MidwestMotorBoy/Double-DRV-Motor-Controller/HARDWARE/DRV8350S_Double/DRV8350S_Double_2.0_Front.jpg

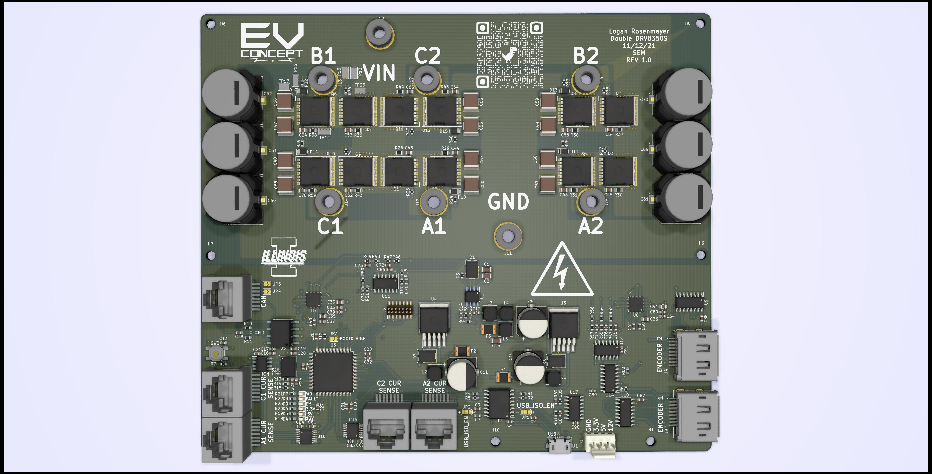
HARDWARE/DRV8350S_Double/DRV8350S_Double_2.0_Front.jpg
