MidwestMotorBoy/Double-DRV-Motor-Controller/HARDWARE/MA732_encoder/MA732_encoder/MA710_encoder_back.jpg

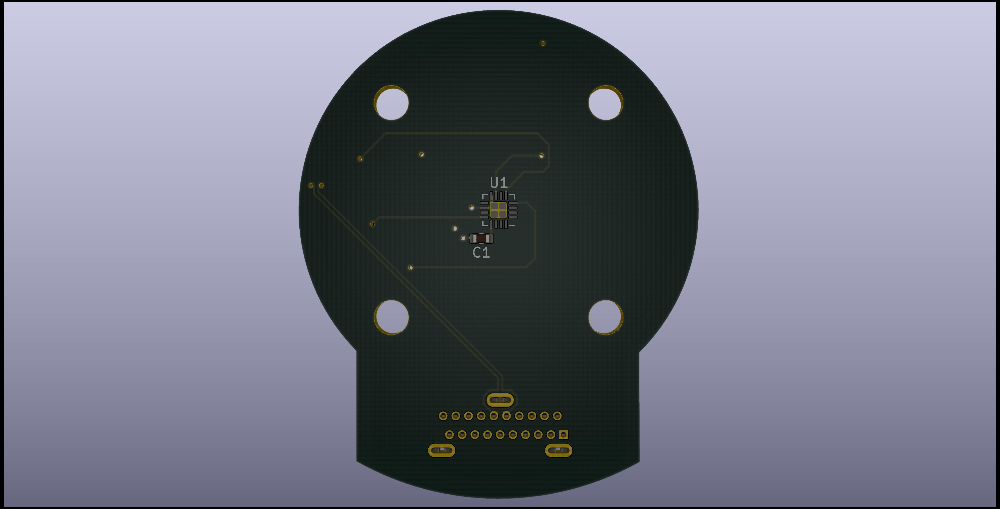
HARDWARE/MA732_encoder/MA732_encoder/MA710_encoder_back.jpg
