MidwestMotorBoy/Double-DRV-Motor-Controller/HARDWARE/DRV8350S_Double/DRV8350S_Double.jpg

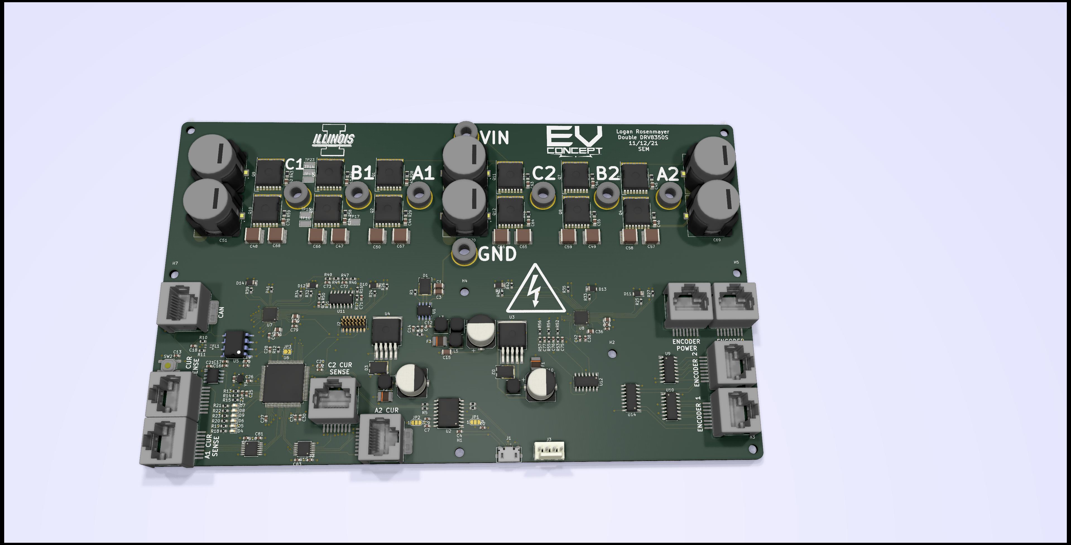
HARDWARE/DRV8350S_Double/DRV8350S_Double.jpg
