MidwestMotorBoy/Double-DRV-Motor-Controller/HARDWARE/MA732_encoder/MA710_encoder.jpg

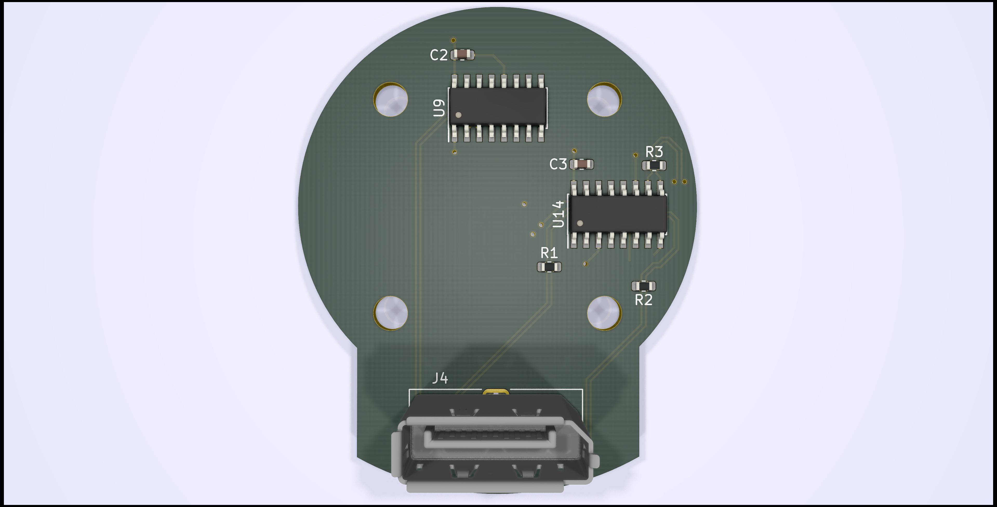
HARDWARE/MA732_encoder/MA710_encoder.jpg
