MidwestMotorBoy/Double-DRV-Motor-Controller/HARDWARE/DRV8350S_Double/SCHEM_0.5.pdf

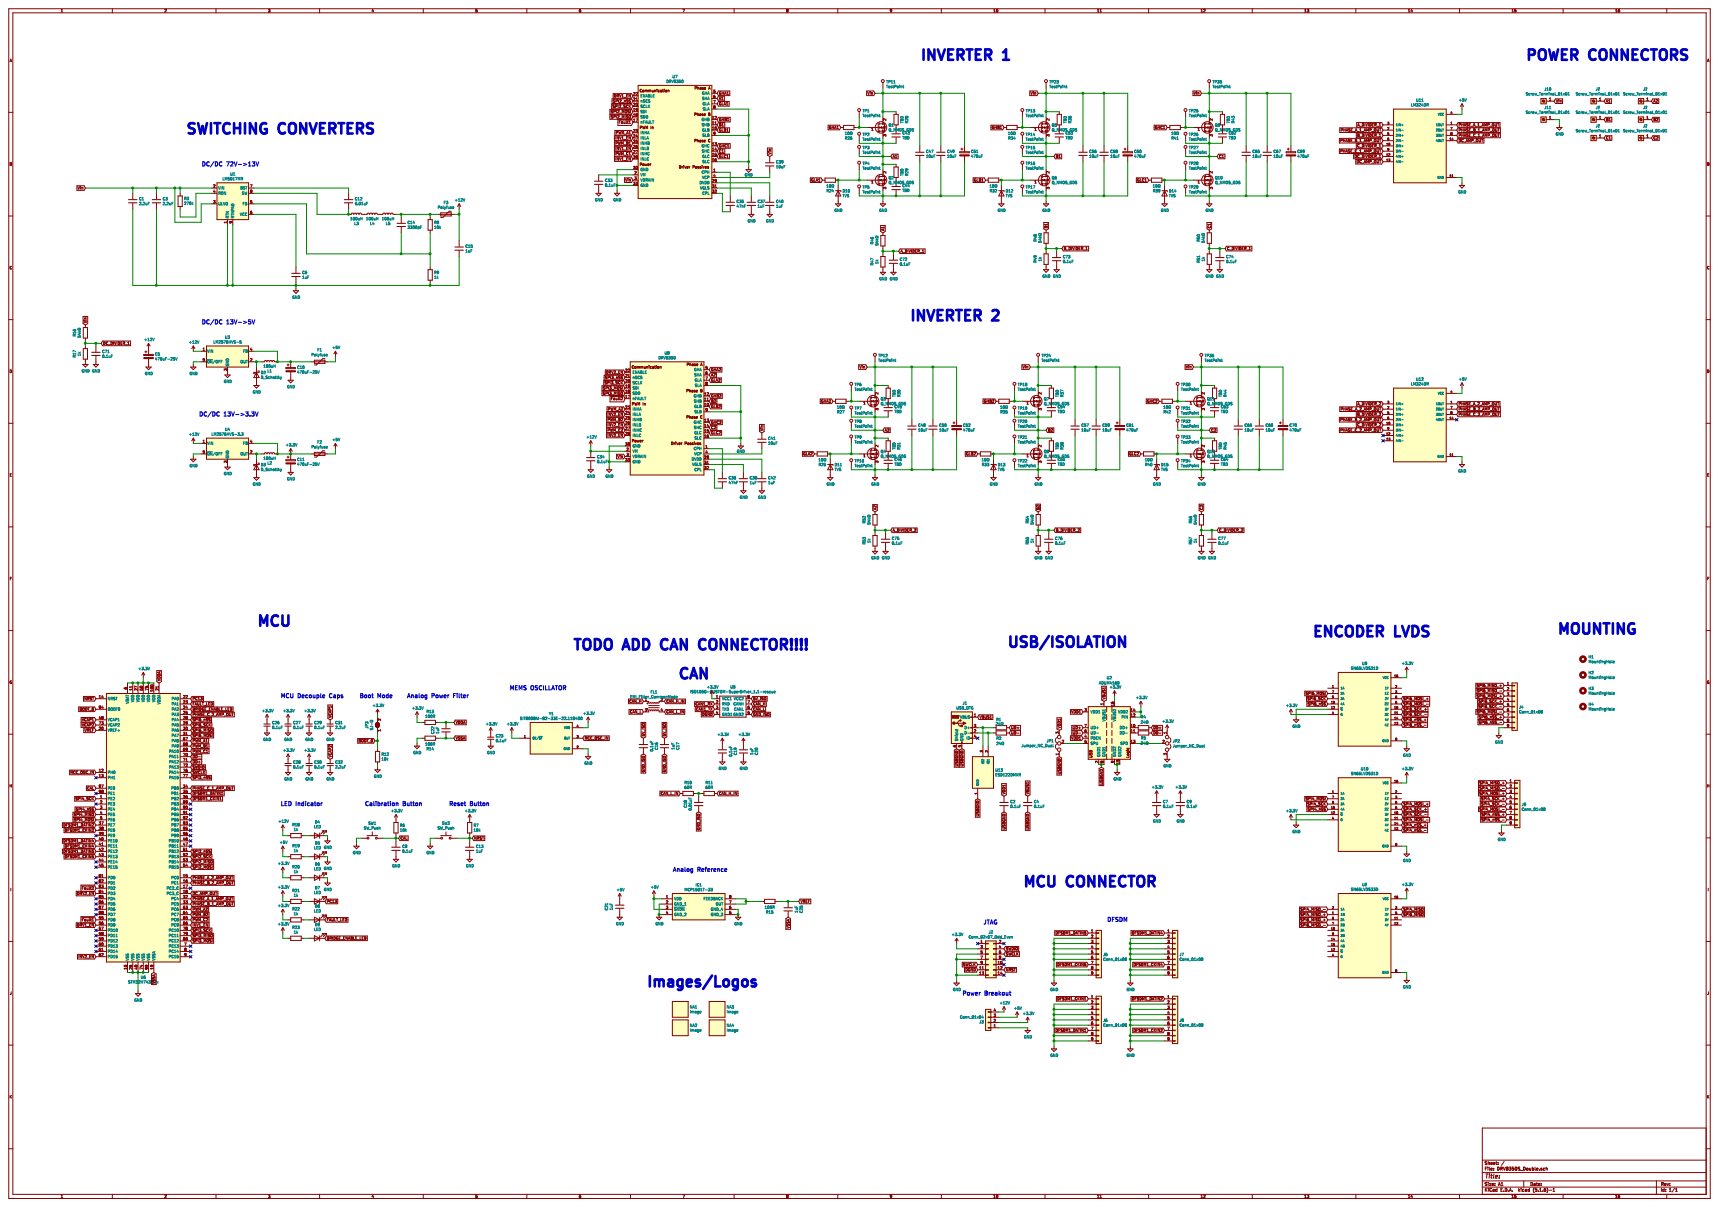
[picture p8: page 1]
