MidwestMotorBoy/Double-DRV-Motor-Controller/HARDWARE/MA732_encoder/MA710_encoder.kicad_pcb

## KiCad design HARDWARE/MA732_encoder/MA710_encoder.kicad_pcb (2022-06-25)

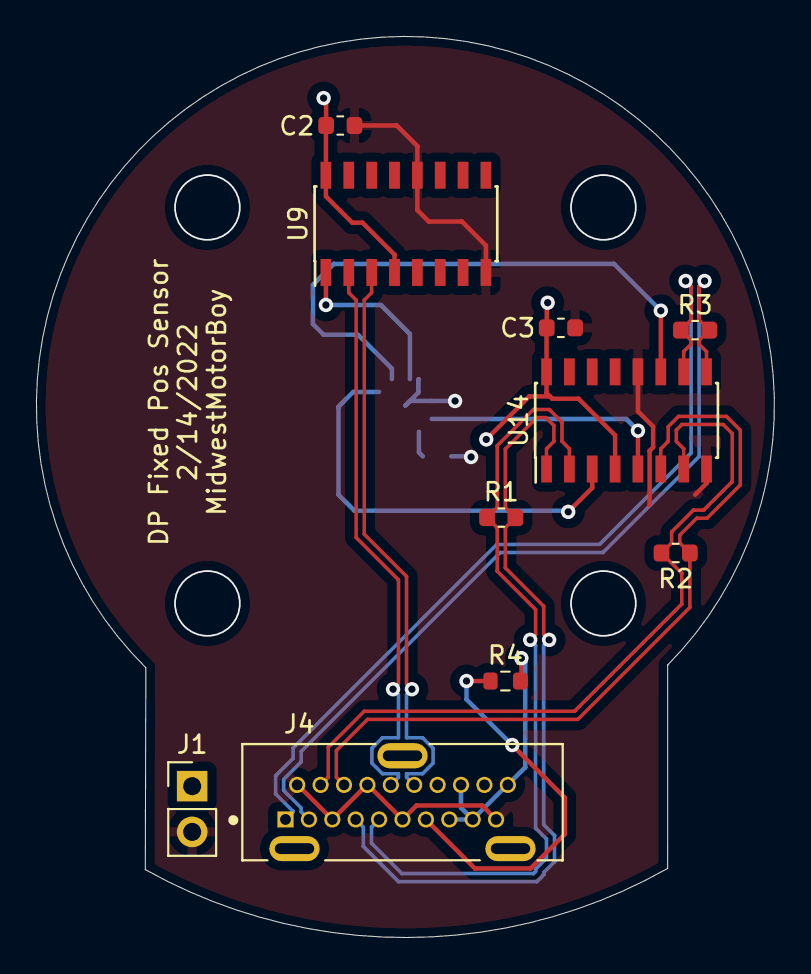
[picture p9: board HARDWARE/MA732_encoder/MA710_encoder.kicad_pcb from above]

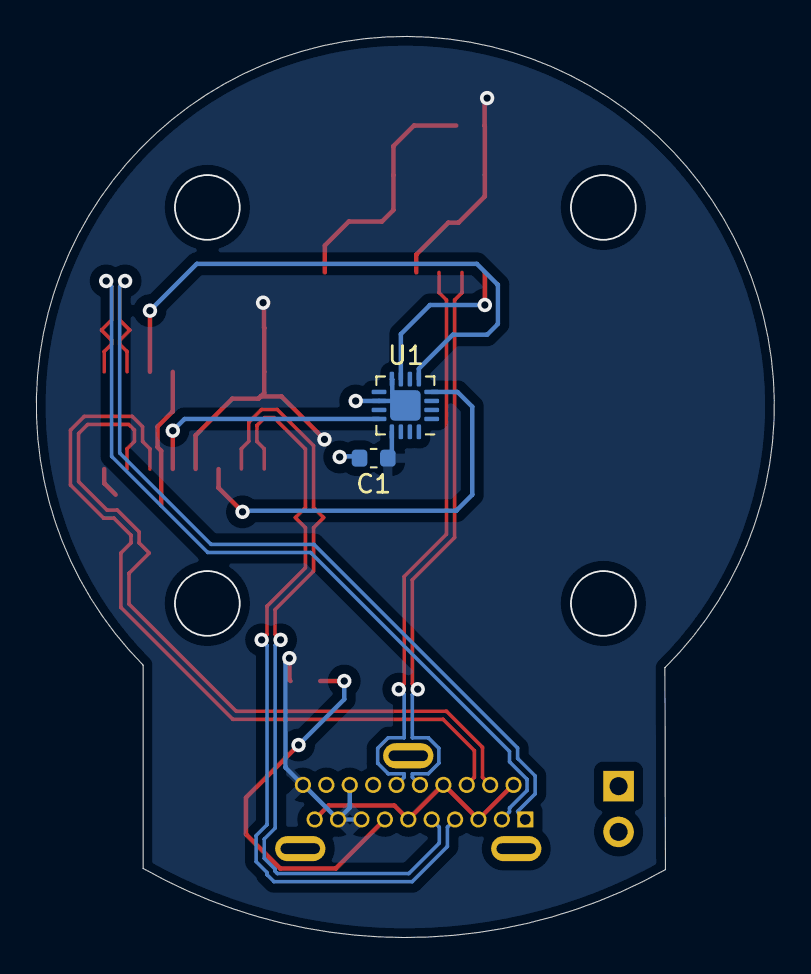
[picture p10: board HARDWARE/MA732_encoder/MA710_encoder.kicad_pcb from below]

Board: 2 copper layers, 41.0 x 50.1 mm, 12 parts (2 on the bottom side), 15 nets.

Parts:
C1, C2, C3: 1uF; C_0603_1608Metric
J1: Conn_01x02_Male; PinHeader_1x02_P2.54mm_Vertical
J4: 47272-0001; TE_2041441-1
R1, R2, R3: 100Ω; R_0603_1608Metric
R4: 0Ω; R_0603_1608Metric
U1: MA730; QFN-16-1EP_3x3mm_P0.5mm_EP1.7x1.7mm
U9: SN65LVDS31D; SOIC-16_3.9x9.9mm_P1.27mm
U14: SN65LVDS33D; SOIC-16_3.9x9.9mm_P1.27mm

Connections:
+3V3: C1.1, C2.1, C3.1, J4.15, J4.16, J4.17, J4.20, R4.2, U1.13 (VDD), U9.4 (G), U9.16 (VCC), U14.4 (G), U14.16 (VCC)
GND: C1.2, C2.2, C3.2, J1.2, J4.2, J4.5, J4.8, J4.11, J4.19, U1.8 (GND), U1.10 (TEST), U1.17 (PAD), U9.8 (GND), U9.12 (~G), U14.8 (GND), U14.12 (~G)
SPI6_MISO: U1.7 (MISO), U9.1 (1A)
SPI6_MISO_+: J4.12, U9.3 (1Z)
SPI6_MISO_-: J4.10, U9.2 (1Y)
SPI6_MOSI: U1.4 (MOSI), U14.3 (1Y)
SPI6_MOSI_+: J4.9, R1.1, U14.2 (1A)
SPI6_MOSI_-: J4.7, R1.2, U14.1 (1B)
SPI6_SCK: U1.12 (SCLK), U14.5 (2Y)
SPI6_SCK_+: J4.6, R2.1, U14.6 (2A)
SPI6_SCK_-: J4.4, R2.2, U14.7 (2B)
SPI6_nSS: U1.5 (~CS), U14.11 (3Y)
SPI6_nSS_+: J4.3, R3.1, U14.9 (3B)
SPI6_nSS_-: J4.1, R3.2, U14.10 (3A)
TEMP_1: J1.1, J4.13, R4.1
