MidwestMotorBoy/Double-DRV-Motor-Controller/HARDWARE/CURRENT_SENSE/Current_Sense.kicad_pcb

## KiCad design HARDWARE/CURRENT_SENSE/Current_Sense.kicad_pcb (2022-06-25)

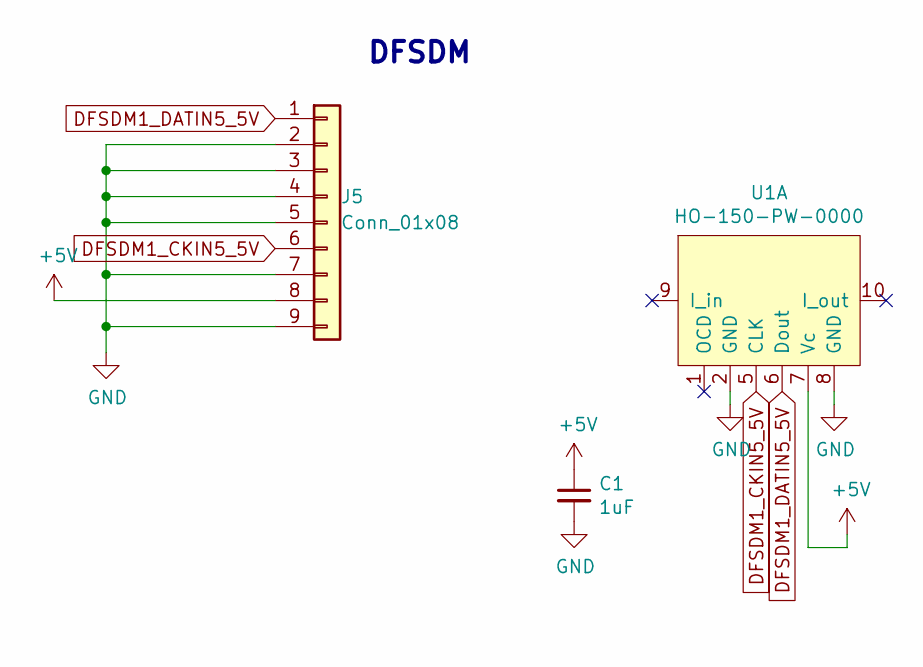
[picture p11: schematic Current_Sense.sch]

Parts:
C1: 1uF; C_0603_1608Metric
J5: Conn_01x08; RCH-RC02015
U1: HO-150-PW-0000

Connections:
+5V: C1.1, J5.8, U1.7 (Vc)
DFSDM1_CKIN5_5V: J5.6, U1.5 (CLK)
DFSDM1_DATIN5_5V: J5.1, U1.6 (Dout)
GND: C1.2, J5.2, J5.3, J5.4, J5.5, J5.7, J5.9, U1.2 (GND), U1.8 (GND)

Notes on the sheet:
DFSDM

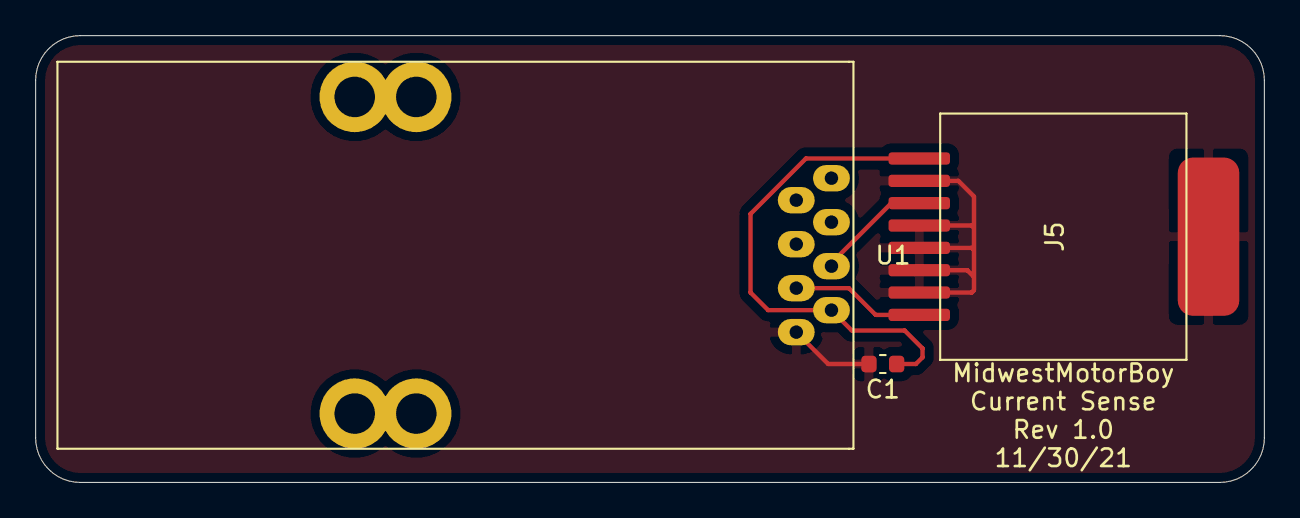
[picture p12: board Current_Sense.kicad_pcb from above]

Board: 2 copper layers, 69.8 x 25.4 mm, 3 parts (0 on the bottom side), 4 nets.
