MidwestMotorBoy/Double-DRV-Motor-Controller/HARDWARE/DRV8350S_Double/DRV8350S_Double.kicad_pcb

## KiCad design HARDWARE/DRV8350S_Double/DRV8350S_Double.kicad_pcb (2022-06-25)

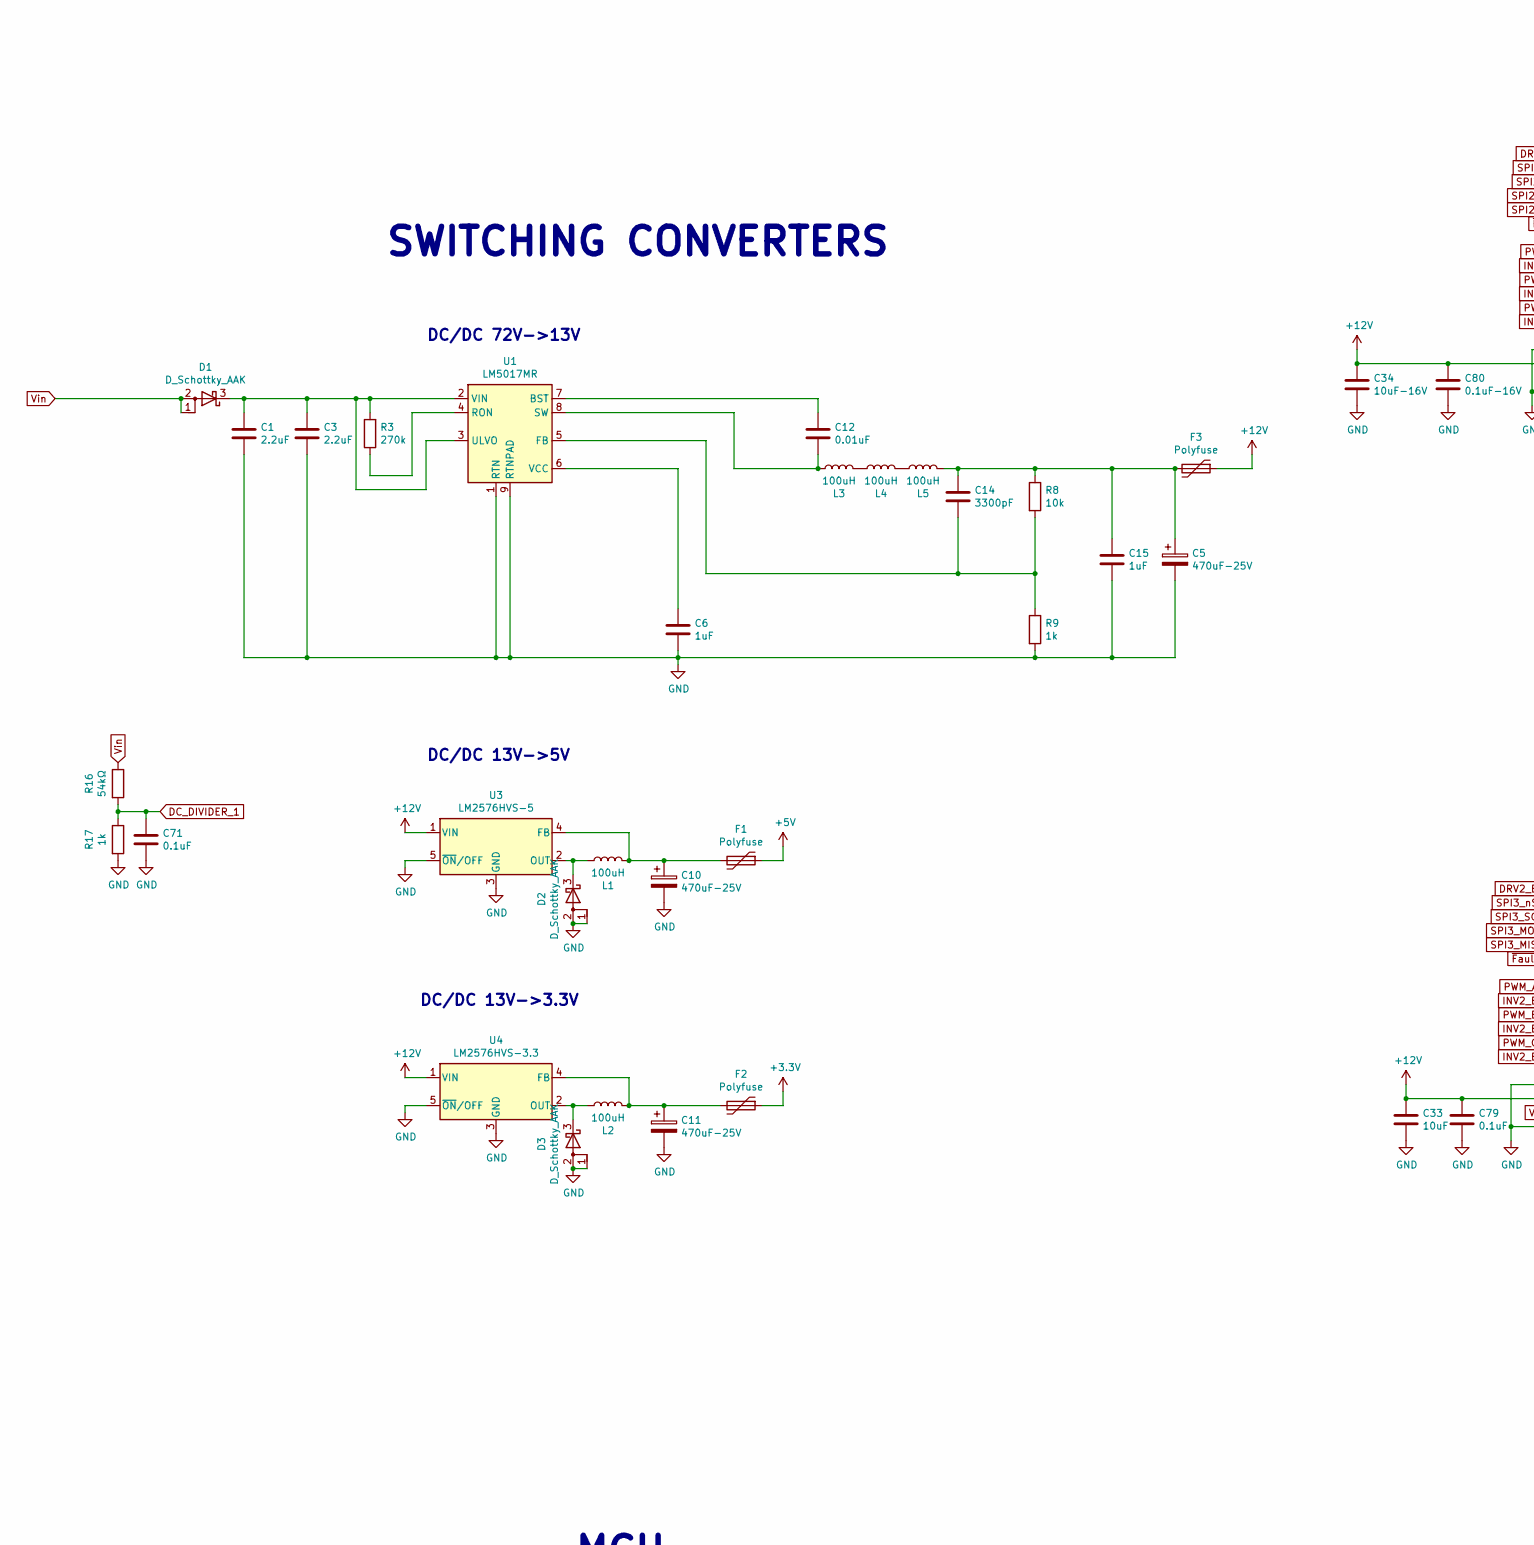
[picture p13: schematic DRV8350S_Double.kicad_sch, part in row 1, column 1]

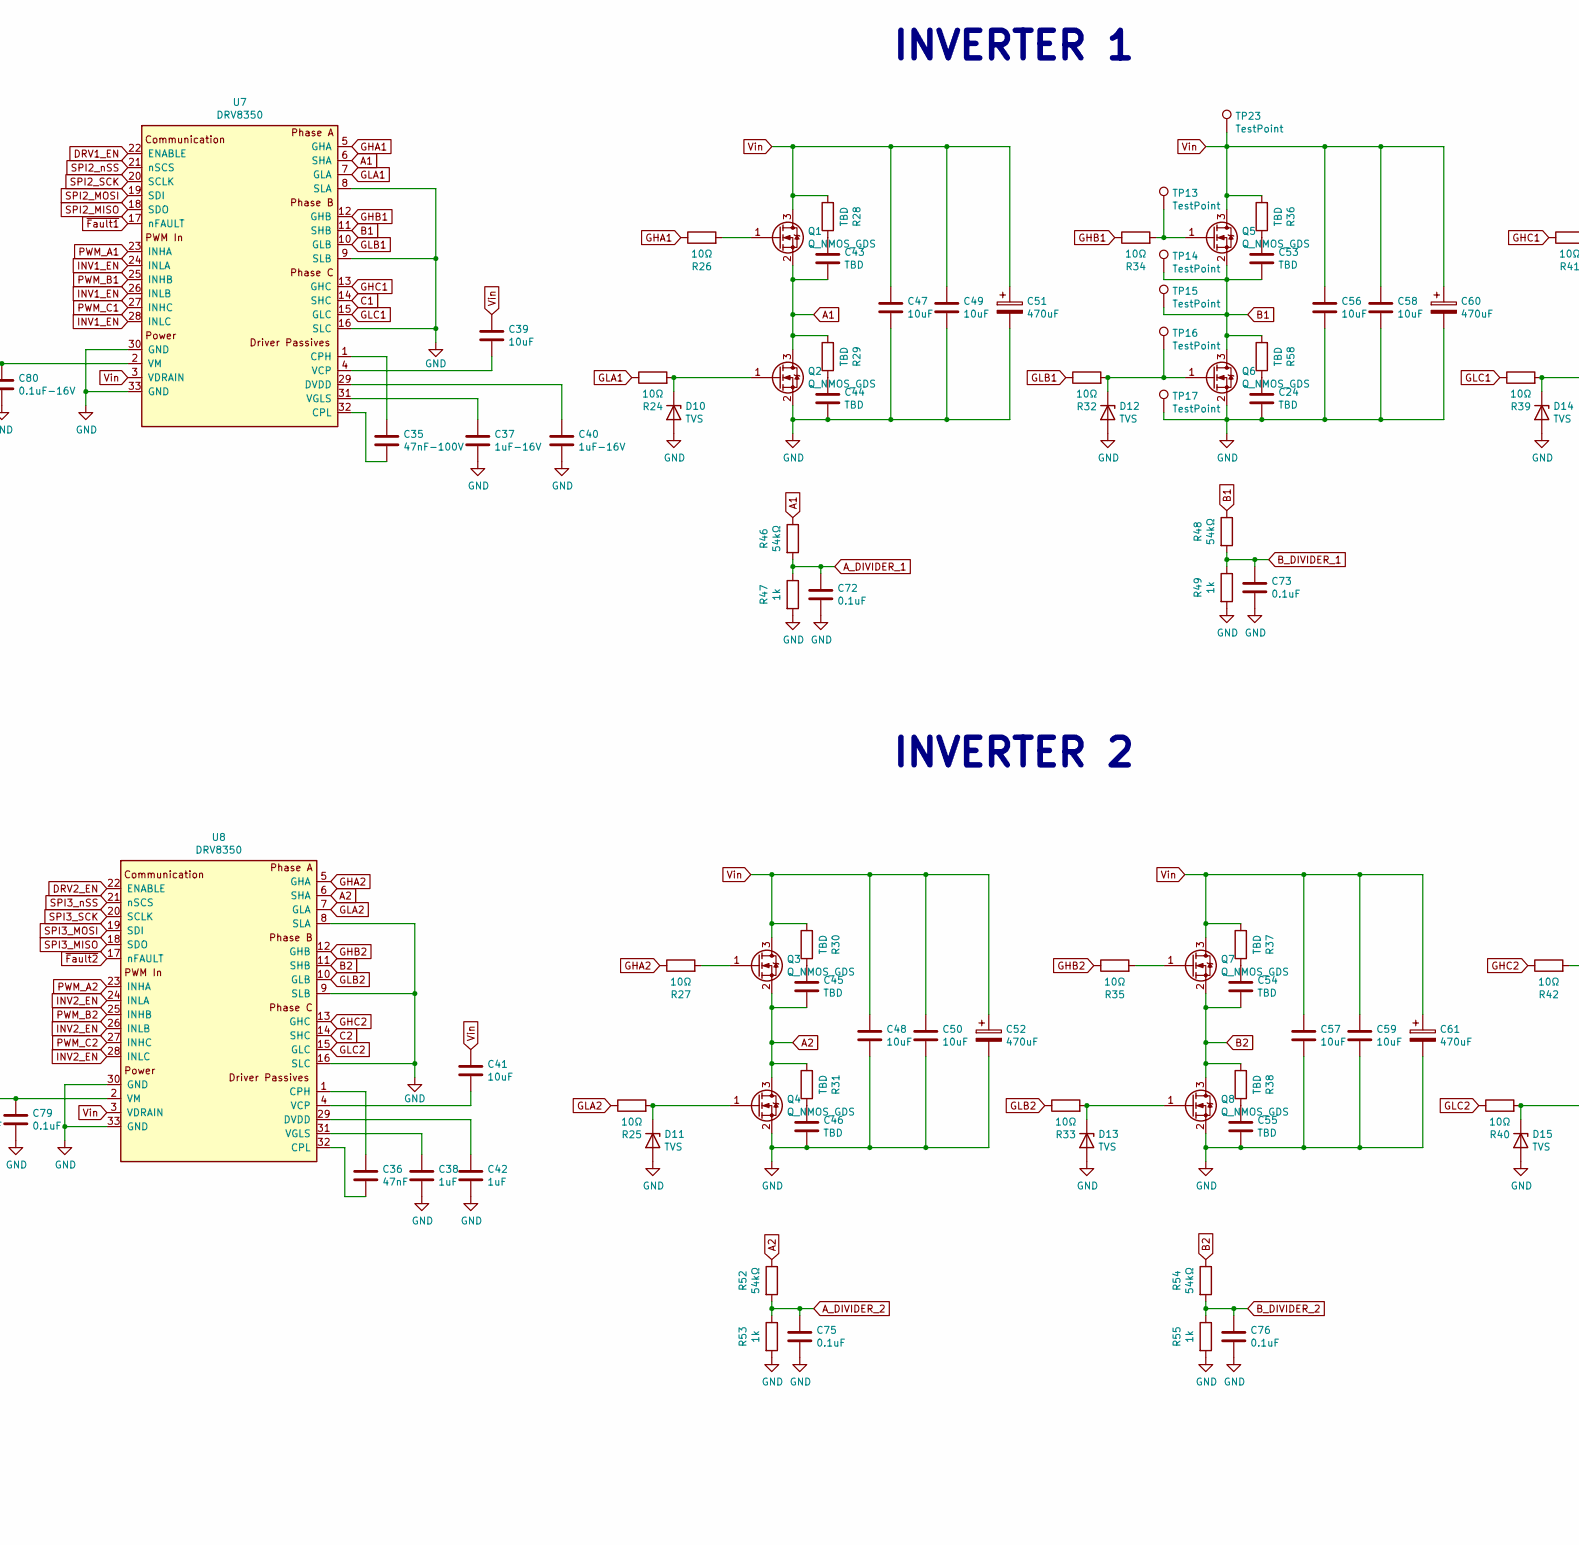
[picture p14: schematic DRV8350S_Double.kicad_sch, part in row 1, column 2]

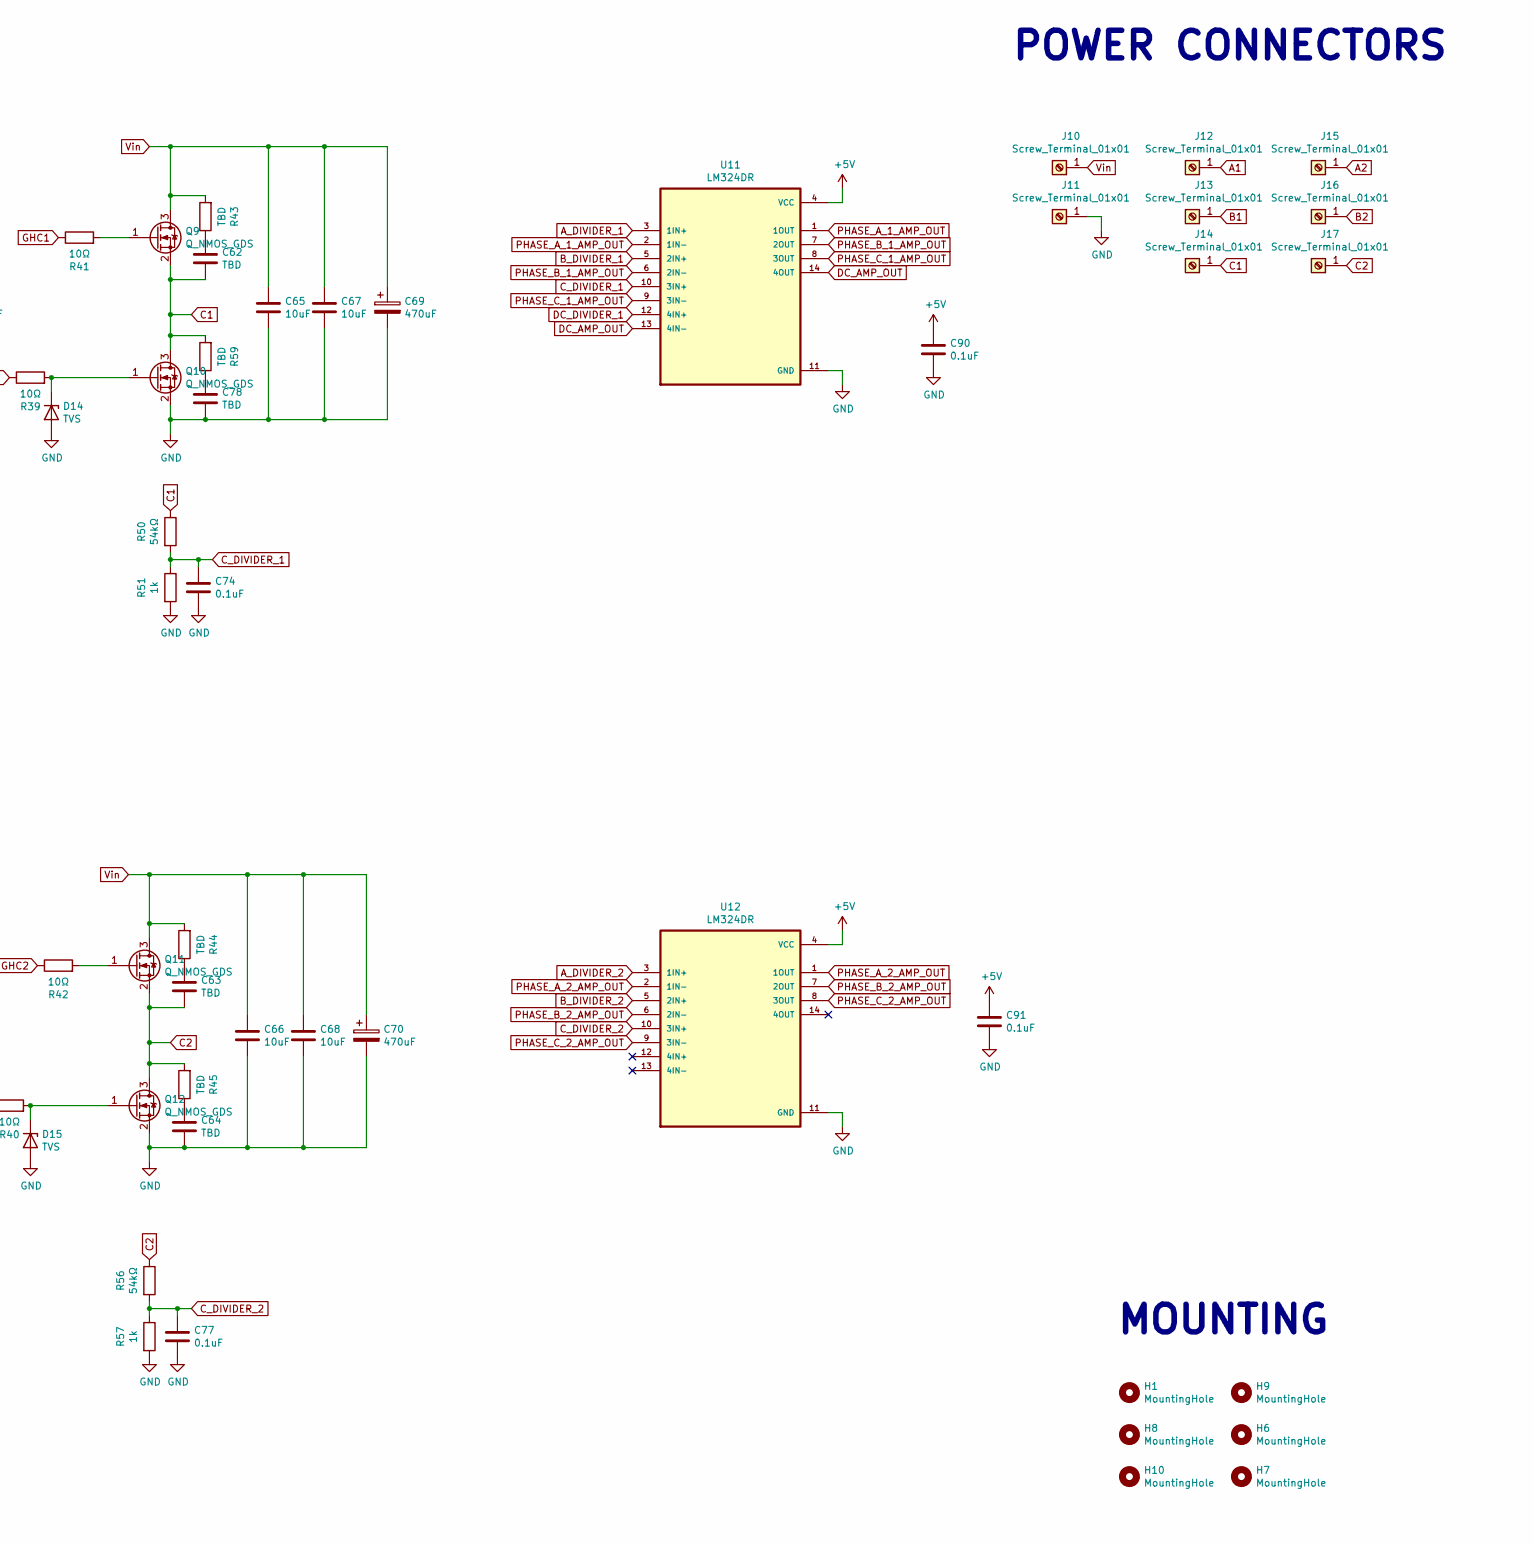
[picture p15: schematic DRV8350S_Double.kicad_sch, part in row 1, column 3]

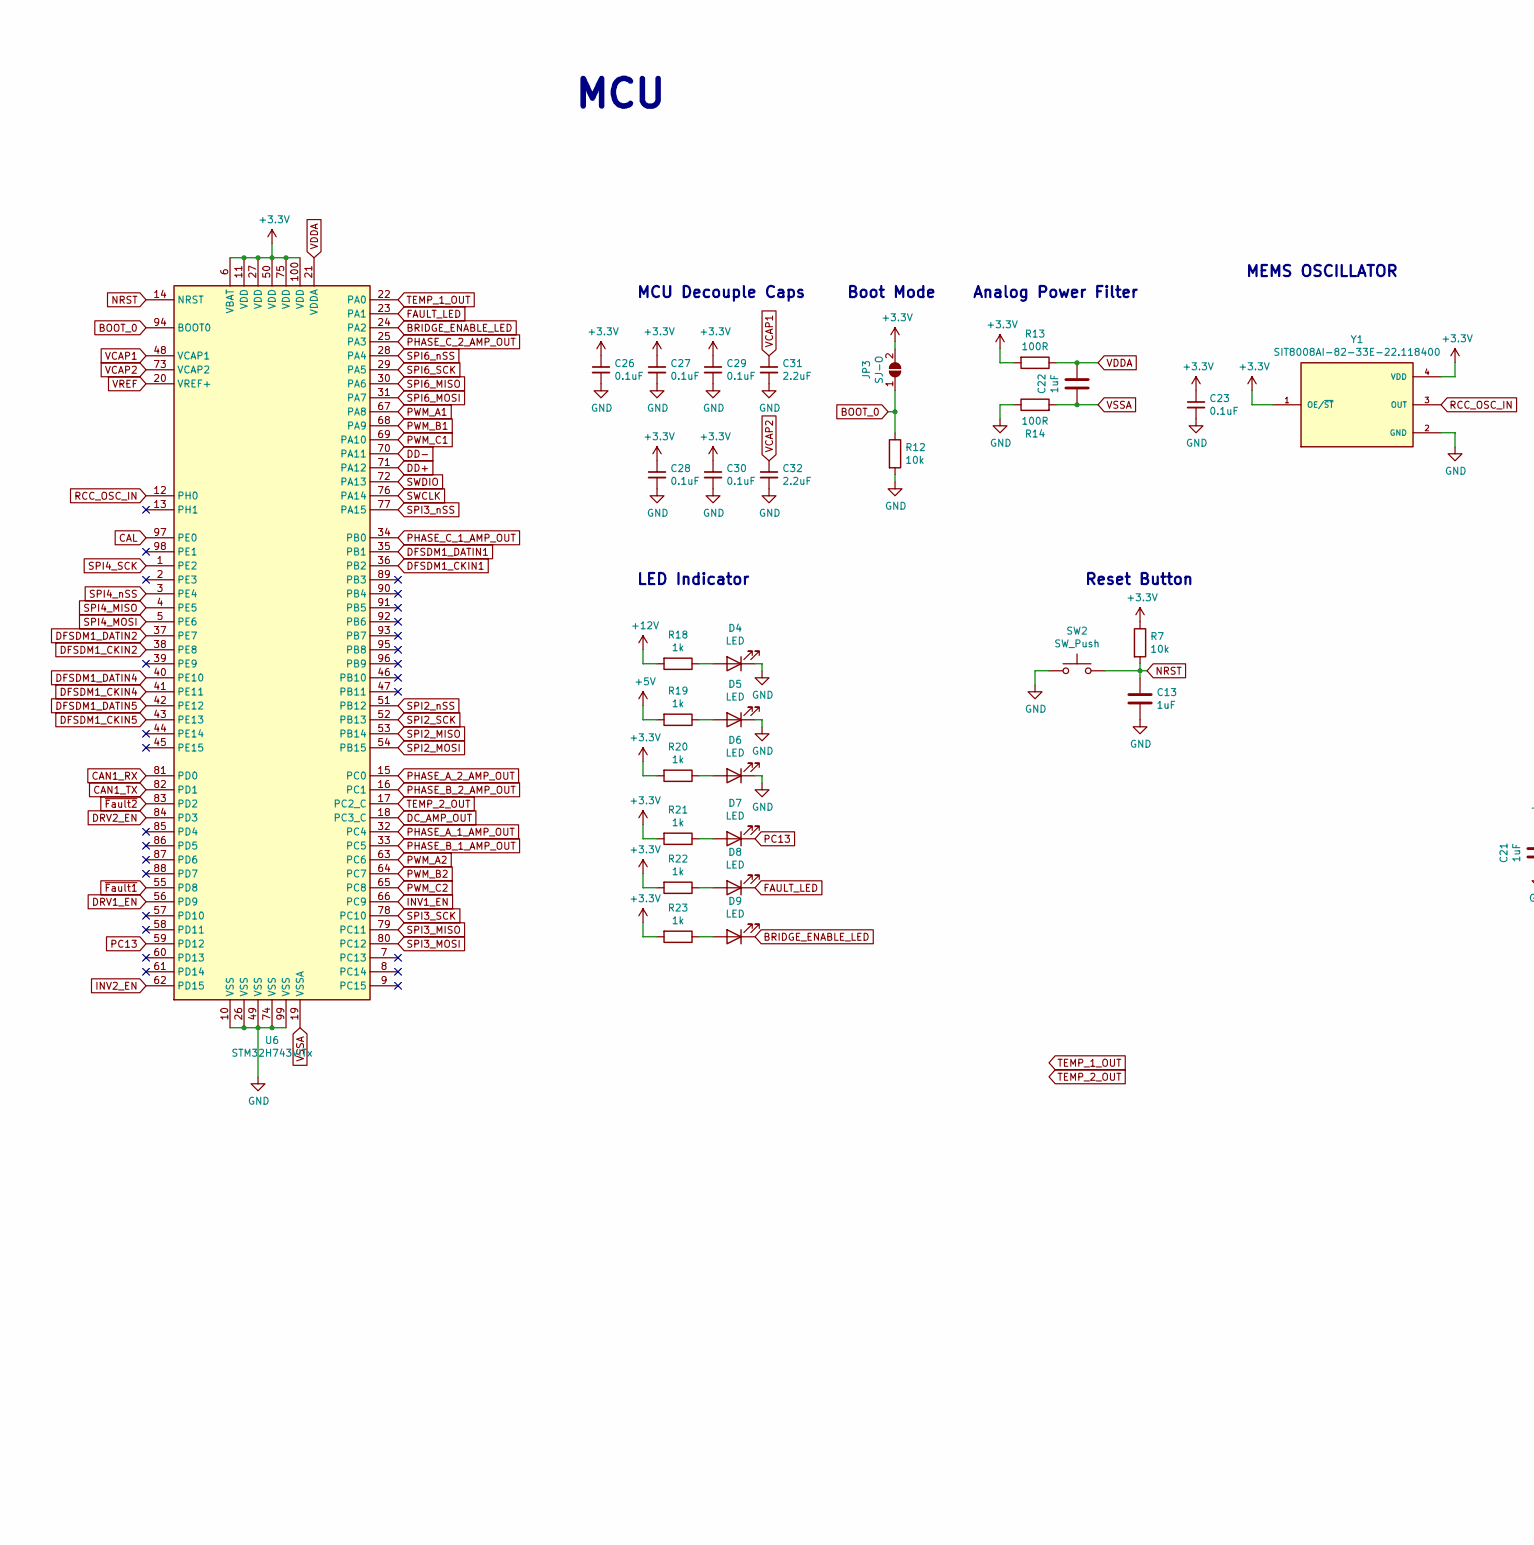
[picture p16: schematic DRV8350S_Double.kicad_sch, part in row 2, column 1]

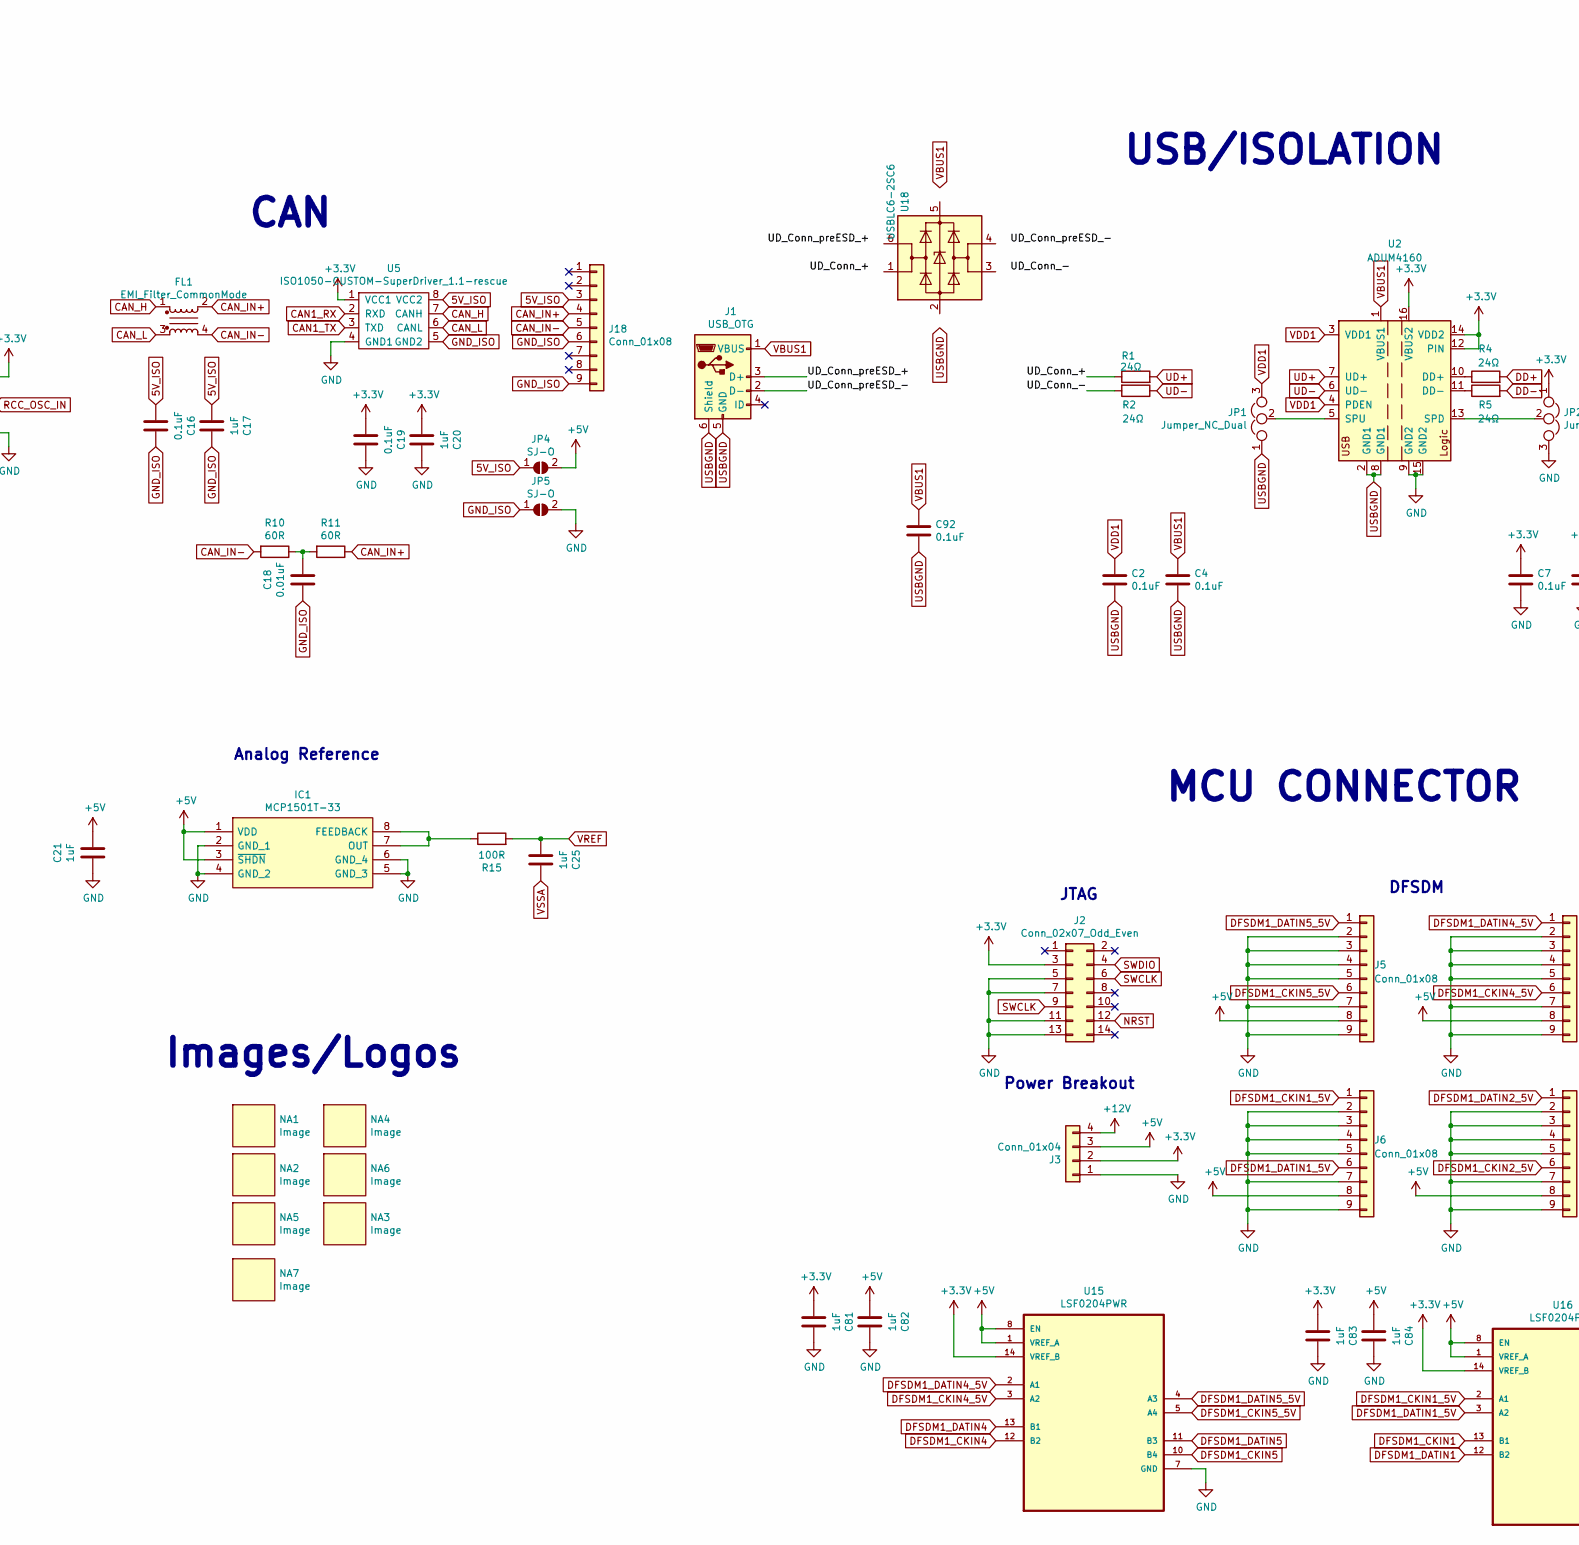
[picture p17: schematic DRV8350S_Double.kicad_sch, part in row 2, column 2]

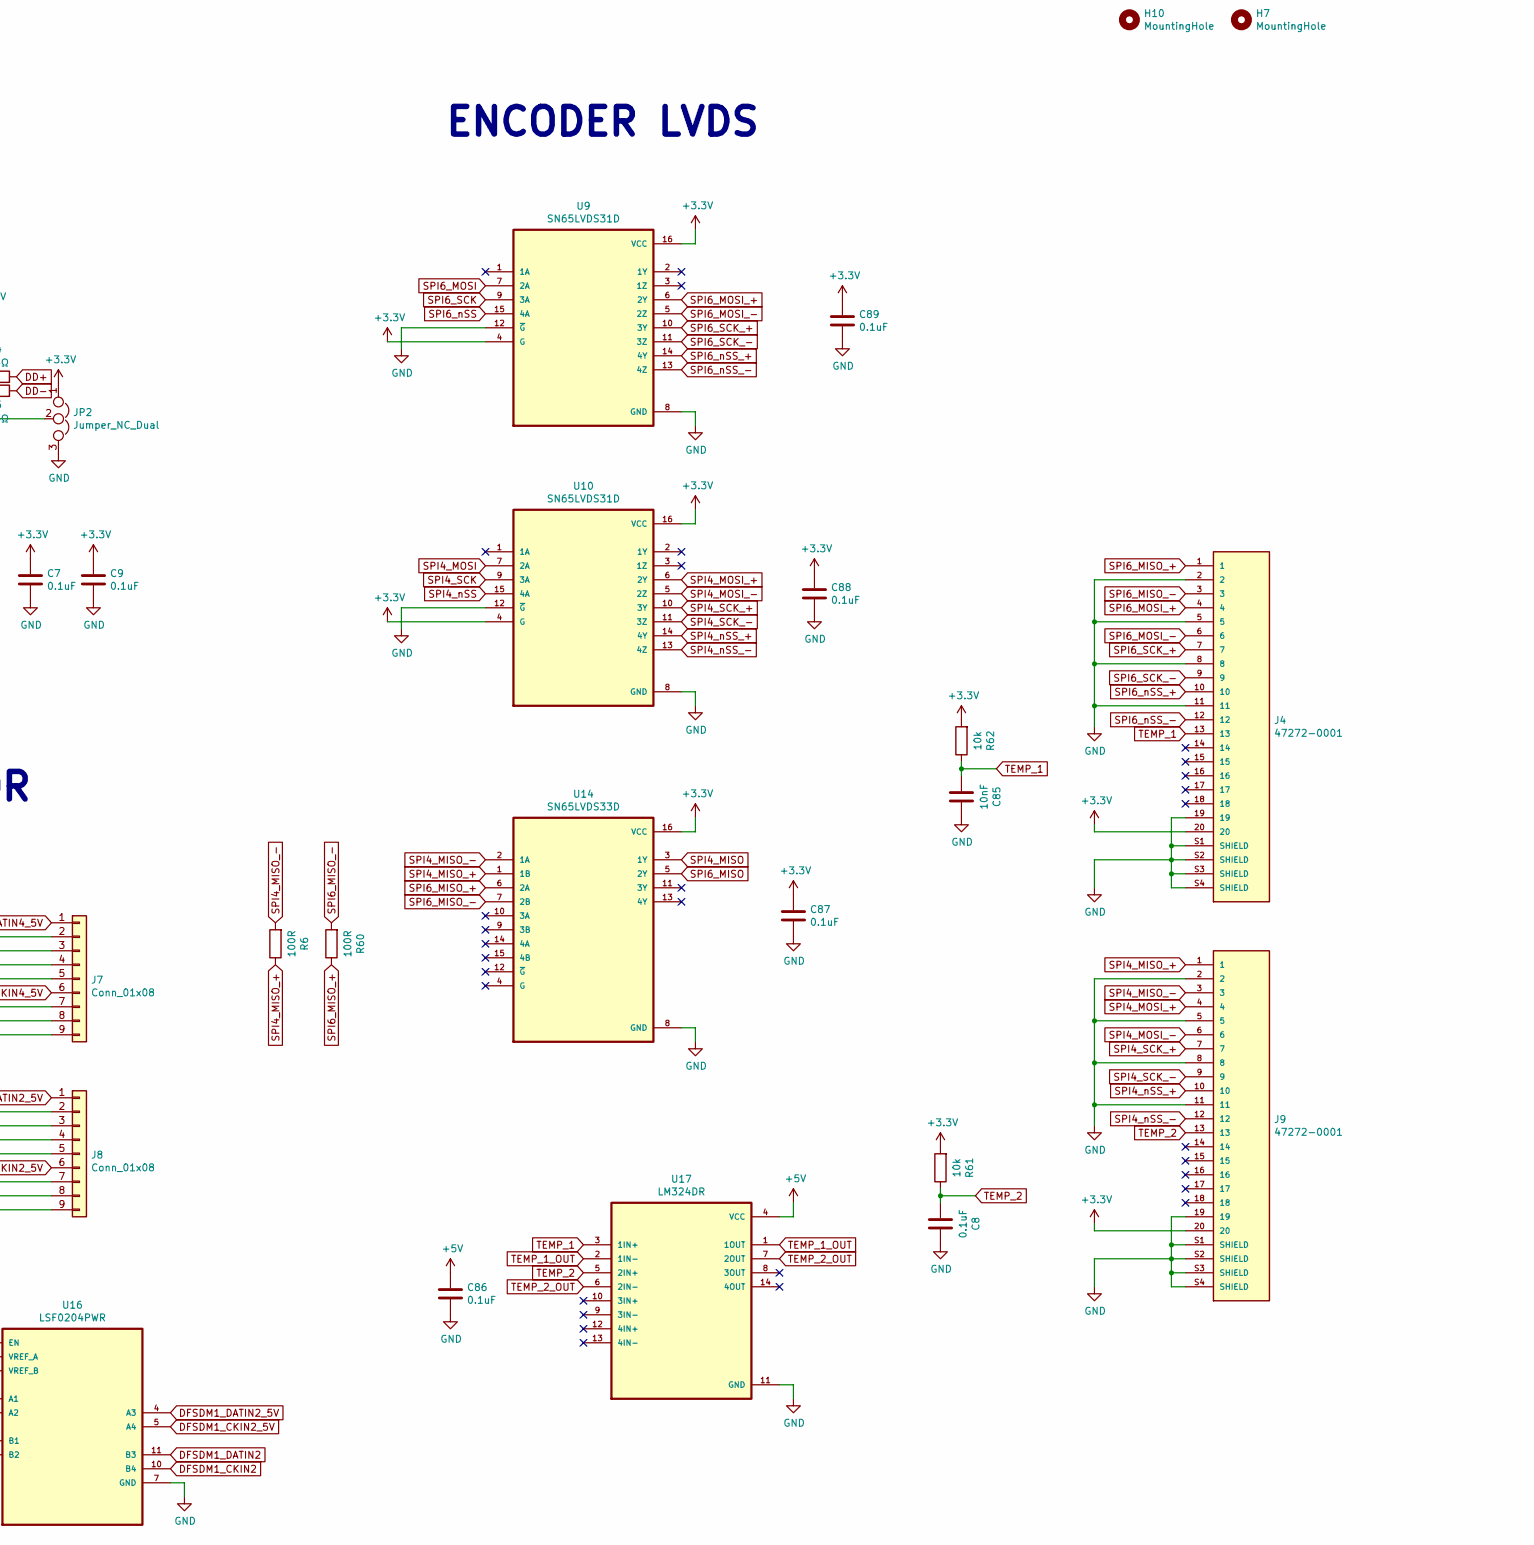
[picture p18: schematic DRV8350S_Double.kicad_sch, part in row 2, column 3]

Parts:
C1, C3: 2.2uF; C_1206_3216Metric
C2, C4, C7, C8, C9, C16, C19, C23, C26, C27, C28, C29, C30, C71, C72, C73, C74, C75, C76, C77, C79, C86, C87, C88, C89, C90, C91, C92: 0.1uF; C_0603_1608Metric
C5, C10, C11: 470uF-25V; CP_Elec_10x10
C6, C13, C17, C20, C21, C22, C25, C38, C42, C81, C82, C83, C84: 1uF; C_0603_1608Metric
C12, C18: 0.01uF; C_0603_1608Metric
C14: 3300pF; C_0603_1608Metric
C15: 1uF; C_1206_3216Metric
C24, C43, C44, C45, C46, C53, C54, C55, C62, C63, C64, C78: TBD; C_0805_2012Metric
C31, C32: 2.2uF; C_0603_1608Metric
C33: 10uF; C_0603_1608Metric
C34: 10uF-16V; C_0603_1608Metric
C35: 47nF-100V; C_0805_2012Metric
C36: 47nF; C_0805_2012Metric
C37, C40: 1uF-16V; C_0603_1608Metric
C39, C41: 10uF; C_0805_2012Metric
C47, C48, C49, C50, C56, C57, C58, C59, C65, C66, C67, C68: 10uF; C_2220_5650Metric
C51, C52, C60, C61, C69, C70: 470uF; CAP_EEETP70471V
C80: 0.1uF-16V; C_0603_1608Metric
C85: 10nF; C_0603_1608Metric
D1, D2, D3: D_Schottky_AAK; TO-277A
D4, D5, D6, D7, D8, D9: LED; LED_0603_1608Metric
D10, D11, D12, D13, D14, D15: TVS; D_PowerDI-123
F1, F2, F3: Polyfuse; Fuse_1812_4532Metric
FL1: EMI_Filter_CommonMode; SRF2012A
H1, H6, H7, H8, H9, H10: MountingHole; MountingHole_3.2mm_M3
IC1: MCP1501T-33; SOIC127P600X175-8N; Mouser Part Number 579-MCP1501T-33E/SN
J1: USB_OTG; USB
J2: Conn_02x07_Odd_Even; PinHeader_2x07_P1.27mm_Vertical_SMD
J3: Conn_01x04; Molex_KK-254_AE-6410-04A_1x04_P2.54mm_Vertical
J4, J9: 47272-0001; MOLEX_47272-0001
J5, J6, J7, J8, J18: Conn_01x08; RCH-RC02015
J10, J11, J12, J13, J14, J15, J16, J17: Screw_Terminal_01x01; 7466005R‎_2ndapt
JP1, JP2: Jumper_NC_Dual; SolderJumper-3_P1.3mm_Open_RoundedPad1.0x1.5mm_NumberLabels
JP3, JP4, JP5: SJ-O; SolderJumper-2_P1.3mm_Open_TrianglePad1.0x1.5mm
L1, L2, L3, L4, L5: 100uH; L_Taiyo-Yuden_MD-5050
NA1: Image; blockI
NA2: Image; teamlogo
NA3: Image; qrcode_github
NA4: Image; voltage_warning
NA5: Image; Dont_get_brazen_with_me!
NA6: Image; biger
NA7: Image; qr_code_rick_roll
Q1, Q2, Q3, Q4, Q5, Q6, Q7, Q8, Q9, Q10, Q11, Q12: Q_NMOS_GDS; Infineon_PG-HSOF-8-1
R1, R2, R4, R5: 24Ω; R_0603_1608Metric
R3: 270k; R_0603_1608Metric
R6, R13, R14, R15, R60: 100R; R_0603_1608Metric
R7, R8, R12, R61, R62: 10k; R_0603_1608Metric
R9, R17, R18, R19, R20, R21, R22, R23, R47, R49, R51, R53, R55, R57: 1k; R_0603_1608Metric
R10, R11: 60R; R_0603_1608Metric
R16, R46, R48, R50, R52, R54, R56: 54kΩ; R_0603_1608Metric
R24, R25, R26, R27, R32, R33, R34, R35, R39, R40, R41, R42: 10Ω; R_0603_1608Metric
R28, R29, R30, R31, R36, R37, R38, R43, R44, R45, R58, R59: TBD; R_0805_2012Metric
SW2: SW_Push; SW_SPST_SKQG_WithStem
TP13, TP14, TP15, TP16, TP17, TP23: TestPoint; TestPoint_Keystone_5019_Minature
U1: LM5017MR; SOIC-8-1EP_3.9x4.9mm_P1.27mm_EP2.95x4.9mm_Mask2.71x3.4mm_Th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
U2: ADUM4160; SOIC-16W_7.5x10.3mm_P1.27mm
U3: LM2576HVS-5; TO-263-5_TabPin3
U4: LM2576HVS-3.3; TO-263-5_TabPin3
U5: ISO1050-CUSTOM-SuperDriver_1.1-rescue; SOP-8_6.62x9.15mm_P2.54mm
U6: STM32H743VITx; LQFP-100_14x14mm_P0.5mm
U7, U8: DRV8350; QFN-32-1EP_5x5mm_P0.5mm_EP3.45x3.45mm_ThermalVias
U9, U10: SN65LVDS31D; SOIC-16_3.9x9.9mm_P1.27mm
U11, U12, U17: LM324DR; SOIC-14_3.9x8.7mm_P1.27mm
U14: SN65LVDS33D; SOIC-16_3.9x9.9mm_P1.27mm
U15, U16: LSF0204PWR; TSSOP-14_4.4x5mm_P0.65mm
U18: USBLC6-2SC6; SOT-666
Y1: SIT8008AI-82-33E-22.118400; OSC_SIT8008AI-73-33E-33.333333G; PARTREV 1.11

Connections:
5V_ISO: C16.2, C17.1, J18.3, JP4.1 (A), U5.8 (VCC2)
+3V3: C7.1, C9.1, C19.2, C20.2, C23.1, C26.1, C27.1, C28.1, C29.1, C30.1, C81.2, C83.2, C87.1, C88.1, C89.1, F2.1, J2.3, J3.2, J4.20, J9.20, JP2.1, JP3.2 (B), R7.1, R13.2, R20.2, R21.2, R22.2, R23.2, R61.2, R62.2, U2.12 (PIN), U2.14 (VDD2), U2.16 (VBUS2), U5.1 (VCC1), U6.6 (VBAT), U6.11 (VDD), U6.27 (VDD), U6.50 (VDD), U6.75 (VDD), U6.100 (VDD), U9.4 (G), U9.16 (VCC), U10.4 (G), U10.16 (VCC), U14.16 (VCC), U15.14 (VREF_B), U16.14 (VREF_B), Y1.1 (OE/~ST), Y1.4 (VDD)
+5V: C21.1, C82.2, C84.2, C86.1, C90.1, C91.1, F1.1, IC1.1 (VDD), IC1.3 (~SHDN), J3.3, J5.8, J6.8, J7.8, J8.8, JP4.2 (B), R19.2, U11.4 (VCC), U12.4 (VCC), U15.1 (VREF_A), U15.8 (EN), U16.1 (VREF_A), U16.8 (EN), U17.4 (VCC)
+12V: C33.1, C34.1, C79.1, C80.1, F3.1, J3.4, R18.2, U3.1 (VIN), U4.1 (VIN), U7.2 (VM), U8.2 (VM)
/UD_Conn_+: R1.1, U18.1 (I/O1)
/UD_Conn_-: R2.2, U18.3 (I/O2)
/UD_Conn_preESD_+: J1.3 (D+), U18.6 (I/O1)
/UD_Conn_preESD_-: J1.2 (D-), U18.4 (I/O2)
A1: C43.2, J12.1, Q1.2 (S), Q2.3 (D), R29.2, R46.1, U7.6 (SHA)
A2: C45.2, J15.1, Q3.2 (S), Q4.3 (D), R31.2, R52.1, U8.6 (SHA)
A_DIVIDER_1: C72.1, R46.2, R47.1, U11.3 (1IN+)
A_DIVIDER_2: C75.1, R52.2, R53.1, U12.3 (1IN+)
B1: C53.2, J13.1, Q5.2 (S), Q6.3 (D), R48.1, R58.2, TP14.1, TP15.1, U7.11 (SHB)
B2: C54.2, J16.1, Q7.2 (S), Q8.3 (D), R38.2, R54.1, U8.11 (SHB)
BOOT_0: JP3.1 (A), R12.1, U6.94 (BOOT0)
BRIDGE_ENABLE_LED: D9.1 (K), U6.24 (PA2)
B_DIVIDER_1: C73.1, R48.2, R49.1, U11.5 (2IN+)
B_DIVIDER_2: C76.1, R54.2, R55.1, U12.5 (2IN+)
C1: C62.2, J14.1, Q9.2 (S), Q10.3 (D), R50.1, R59.2, U7.14 (SHC)
C2: C63.2, J17.1, Q11.2 (S), Q12.3 (D), R45.2, R56.1, U8.14 (SHC)
CAN1_RX: U5.2 (RXD), U6.81 (PD0)
CAN1_TX: U5.3 (TXD), U6.82 (PD1)
CAN_H: FL1.1, U5.7 (CANH)
CAN_IN+: FL1.2, J18.4, R11.1
CAN_IN-: FL1.4, J18.5, R10.2
CAN_L: FL1.3, U5.6 (CANL)
C_DIVIDER_1: C74.1, R50.2, R51.1, U11.10 (3IN+)
C_DIVIDER_2: C77.1, R56.2, R57.1, U12.10 (3IN+)
DC_AMP_OUT: U6.18 (PC3_C), U11.13 (4IN-), U11.14 (4OUT)
DC_DIVIDER_1: C71.1, R16.2, R17.1, U11.12 (4IN+)
DD+: R4.2, U6.71 (PA12)
DD-: R5.2, U6.70 (PA11)
DFSDM1_CKIN1: U6.36 (PB2), U16.13 (B1)
DFSDM1_CKIN1_5V: J6.1, U16.2 (A1)
DFSDM1_CKIN2: U6.38 (PE8), U16.10 (B4)
DFSDM1_CKIN2_5V: J8.6, U16.5 (A4)
DFSDM1_CKIN4: U6.41 (PE11), U15.12 (B2)
DFSDM1_CKIN4_5V: J7.6, U15.3 (A2)
DFSDM1_CKIN5: U6.43 (PE13), U15.10 (B4)
DFSDM1_CKIN5_5V: J5.6, U15.5 (A4)
DFSDM1_DATIN1: U6.35 (PB1), U16.12 (B2)
DFSDM1_DATIN1_5V: J6.6, U16.3 (A2)
DFSDM1_DATIN2: U6.37 (PE7), U16.11 (B3)
DFSDM1_DATIN2_5V: J8.1, U16.4 (A3)
DFSDM1_DATIN4: U6.40 (PE10), U15.13 (B1)
DFSDM1_DATIN4_5V: J7.1, U15.2 (A1)
DFSDM1_DATIN5: U6.42 (PE12), U15.11 (B3)
DFSDM1_DATIN5_5V: J5.1, U15.4 (A3)
DRV1_EN: U6.56 (PD9), U7.22 (ENABLE)
DRV2_EN: U6.84 (PD3), U8.22 (ENABLE)
FAULT_LED: D8.1 (K), U6.23 (PA1)
GHA1: R26.1, U7.5 (GHA)
GHA2: R27.1, U8.5 (GHA)
GHB1: R34.1, U7.12 (GHB)
GHB2: R35.1, U8.12 (GHB)
GHC1: R41.1, U7.13 (GHC)
GHC2: R42.1, U8.13 (GHC)
GLA1: R24.1, U7.7 (GLA)
GLA2: R25.1, U8.7 (GLA)
GLB1: R32.1, U7.10 (GLB)
GLB2: R33.1, U8.10 (GLB)
GLC1: R39.1, U7.15 (GLC)
GLC2: R40.1, U8.15 (GLC)
GND: C1.2, C3.2, C5.2, C6.2, C7.2, C8.1, C9.2, C10.2, C11.2, C13.2, C15.2, C19.1, C20.1, C21.2, C23.2, C24.2, C26.2, C27.2, C28.2, C29.2, C30.2, C31.2, C32.2, C33.2, C34.2, C37.2, C38.2, C40.2, C42.2, C44.2, C46.2, C47.2, C48.2, C49.2, C50.2, C51.2, C52.2, C55.2, C56.2, C57.2, C58.2, C59.2, C60.2, C61.2, C64.2, C65.2, C66.2, C67.2, C68.2, C69.2, C70.2, C71.2, C72.2, C73.2, C74.2, C75.2, C76.2, C77.2, C78.2, C79.2, C80.2, C81.1, C82.1, C83.1, C84.1, C85.1, C86.2, C87.2, C88.2, C89.2, C90.2, C91.2, D2.1 (A), D2.2 (A), D3.1 (A), D3.2 (A), D4.1 (K), D5.1 (K), D6.1 (K), D10.2 (A), D11.2 (A), D12.2 (A), D13.2 (A), D14.2 (A), D15.2 (A), IC1.2 (GND_1), IC1.4 (GND_2), IC1.5 (GND_3), IC1.6 (GND_4), J2.5, J2.7, J2.11, J2.13, J3.1, J4.2, J4.5, J4.8, J4.11, J4.19, J4.S1 (SHIELD), J4.S2 (SHIELD), J4.S3 (SHIELD), J4.S4 (SHIELD), J5.2, J5.3, J5.4, J5.5, J5.7, J5.9, J6.2, J6.3, J6.4, J6.5, J6.7, J6.9, J7.2, J7.3, J7.4, J7.5, J7.7, J7.9, J8.2, J8.3, J8.4, J8.5, J8.7, J8.9, J9.2, J9.5, J9.8, J9.11, J9.19, J9.S1 (SHIELD), J9.S2 (SHIELD), J9.S3 (SHIELD), J9.S4 (SHIELD), J11.1, JP2.3, JP5.2 (B), Q2.2 (S), Q4.2 (S), Q6.2 (S), Q8.2 (S), Q10.2 (S), Q12.2 (S), R9.2, R12.2, R14.1, R17.2, R47.2, R49.2, R51.2, R53.2, R55.2, R57.2, SW2.1, TP17.1, U1.1 (RTN), U1.9 (RTNPAD), U2.9 (GND2), U2.15 (GND2), U3.3 (GND), U3.5 (~ON/OFF), U4.3 (GND), U4.5 (~ON/OFF), U5.4 (GND1), U6.10 (VSS), U6.26 (VSS), U6.49 (VSS), U6.74 (VSS), U6.99 (VSS), U7.8 (SLA), U7.9 (SLB), U7.16 (SLC), U7.30 (GND), U7.33 (GND), U8.8 (SLA), U8.9 (SLB), U8.16 (SLC), U8.30 (GND), U8.33 (GND), U9.8 (GND), U9.12 (~G), U10.8 (GND), U10.12 (~G), U11.11 (GND), U12.11 (GND), U14.8 (GND), U15.7 (GND), U16.7 (GND), U17.11 (GND), Y1.2 (GND)
GND_ISO: C16.1, C17.2, C18.2, J18.6, J18.9, JP5.1 (A), U5.5 (GND2)
INV1_EN: U6.66 (PC9), U7.24 (INLA), U7.26 (INLB), U7.28 (INLC)
INV2_EN: U6.62 (PD15), U8.24 (INLA), U8.26 (INLB), U8.28 (INLC)
NRST: C13.1, J2.12, R7.2, SW2.2, U6.14 (NRST)
unnamed: C1.1, C3.1, D1.3 (K), R3.2, U1.2 (VIN), U1.3 (ULVO)
unnamed: C6.1, U1.6 (VCC)
unnamed: C10.1, F1.2, L1.2, U3.4 (FB)
unnamed: C11.1, F2.2, L2.2, U4.4 (FB)
unnamed: C12.1, U1.7 (BST)
unnamed: C12.2, L3.1, U1.8 (SW)
unnamed: C5.1, C14.1, C15.1, F3.2, L5.2, R8.1
unnamed: C14.2, R8.2, R9.1, U1.5 (FB)
unnamed: C18.1, R10.1, R11.2
unnamed: C24.1, R58.1
unnamed: C35.1, U7.1 (CPH)
unnamed: C35.2, U7.32 (CPL)
unnamed: C36.1, U8.1 (CPH)
unnamed: C36.2, U8.32 (CPL)
unnamed: C37.1, U7.31 (VGLS)
unnamed: C38.1, U8.31 (VGLS)
unnamed: C39.2, U7.4 (VCP)
unnamed: C40.1, U7.29 (DVDD)
unnamed: C41.2, U8.4 (VCP)
unnamed: C42.1, U8.29 (DVDD)
unnamed: C43.1, R28.1
unnamed: C44.1, R29.1
unnamed: C45.1, R30.1
unnamed: C46.1, R31.1
unnamed: C53.1, R36.1
unnamed: C54.1, R37.1
unnamed: C55.1, R38.1
unnamed: C62.1, R43.1
unnamed: C63.1, R44.1
unnamed: C64.1, R45.1
unnamed: C78.1, R59.1
unnamed: D2.3 (K), L1.1, U3.2 (OUT)
unnamed: D3.3 (K), L2.1, U4.2 (OUT)
unnamed: D4.2 (A), R18.1
unnamed: D5.2 (A), R19.1
unnamed: D6.2 (A), R20.1
unnamed: D7.2 (A), R21.1
unnamed: D8.2 (A), R22.1
unnamed: D9.2 (A), R23.1
unnamed: D10.1 (K), Q2.1 (G), R24.2
unnamed: D11.1 (K), Q4.1 (G), R25.2
unnamed: D12.1 (K), Q6.1 (G), R32.2, TP16.1
unnamed: D13.1 (K), Q8.1 (G), R33.2
unnamed: D14.1 (K), Q10.1 (G), R39.2
unnamed: D15.1 (K), Q12.1 (G), R40.2
unnamed: IC1.7 (OUT), IC1.8 (FEEDBACK), R15.1
unnamed: JP1.2, U2.5 (SPU)
unnamed: JP2.2, U2.13 (SPD)
unnamed: L3.2, L4.1
unnamed: L4.2, L5.1
unnamed: Q1.1 (G), R26.2
unnamed: Q3.1 (G), R27.2
unnamed: Q5.1 (G), R34.2, TP13.1
unnamed: Q7.1 (G), R35.2
unnamed: Q9.1 (G), R41.2
unnamed: Q11.1 (G), R42.2
unnamed: R3.1, U1.4 (RON)
unnamed: R4.1, U2.10 (DD+)
unnamed: R5.1, U2.11 (DD-)
PC13: D7.1 (K), U6.59 (PD12)
PHASE_A_1_AMP_OUT: U6.32 (PC4), U11.1 (1OUT), U11.2 (1IN-)
PHASE_A_2_AMP_OUT: U6.15 (PC0), U12.1 (1OUT), U12.2 (1IN-)
PHASE_B_1_AMP_OUT: U6.33 (PC5), U11.6 (2IN-), U11.7 (2OUT)
PHASE_B_2_AMP_OUT: U6.16 (PC1), U12.6 (2IN-), U12.7 (2OUT)
PHASE_C_1_AMP_OUT: U6.34 (PB0), U11.8 (3OUT), U11.9 (3IN-)
PHASE_C_2_AMP_OUT: U6.25 (PA3), U12.8 (3OUT), U12.9 (3IN-)
PWM_A1: U6.67 (PA8), U7.23 (INHA)
PWM_A2: U6.63 (PC6), U8.23 (INHA)
PWM_B1: U6.68 (PA9), U7.25 (INHB)
PWM_B2: U6.64 (PC7), U8.25 (INHB)
PWM_C1: U6.69 (PA10), U7.27 (INHC)
PWM_C2: U6.65 (PC8), U8.27 (INHC)
RCC_OSC_IN: U6.12 (PH0), Y1.3 (OUT)
SPI2_MISO: U6.53 (PB14), U7.18 (SDO)
SPI2_MOSI: U6.54 (PB15), U7.19 (SDI)
SPI2_SCK: U6.52 (PB13), U7.20 (SCLK)
SPI2_nSS: U6.51 (PB12), U7.21 (nSCS)
SPI3_MISO: U6.79 (PC11), U8.18 (SDO)
SPI3_MOSI: U6.80 (PC12), U8.19 (SDI)
SPI3_SCK: U6.78 (PC10), U8.20 (SCLK)
SPI3_nSS: U6.77 (PA15), U8.21 (nSCS)
SPI4_MISO: U6.4 (PE5), U14.3 (1Y)
SPI4_MISO_+: J9.1, R6.1, U14.1 (1B)
SPI4_MISO_-: J9.3, R6.2, U14.2 (1A)
SPI4_MOSI: U6.5 (PE6), U10.7 (2A)
SPI4_MOSI_+: J9.4, U10.6 (2Y)
SPI4_MOSI_-: J9.6, U10.5 (2Z)
SPI4_SCK: U6.1 (PE2), U10.9 (3A)
SPI4_SCK_+: J9.7, U10.10 (3Y)
SPI4_SCK_-: J9.9, U10.11 (3Z)
SPI4_nSS: U6.3 (PE4), U10.15 (4A)
SPI4_nSS_+: J9.10, U10.14 (4Y)
SPI4_nSS_-: J9.12, U10.13 (4Z)
SPI6_MISO: U6.30 (PA6), U14.5 (2Y)
SPI6_MISO_+: J4.1, R60.1, U14.6 (2A)
SPI6_MISO_-: J4.3, R60.2, U14.7 (2B)
SPI6_MOSI: U6.31 (PA7), U9.7 (2A)
SPI6_MOSI_+: J4.4, U9.6 (2Y)
SPI6_MOSI_-: J4.6, U9.5 (2Z)
SPI6_SCK: U6.29 (PA5), U9.9 (3A)
SPI6_SCK_+: J4.7, U9.10 (3Y)
SPI6_SCK_-: J4.9, U9.11 (3Z)
SPI6_nSS: U6.28 (PA4), U9.15 (4A)
SPI6_nSS_+: J4.10, U9.14 (4Y)
SPI6_nSS_-: J4.12, U9.13 (4Z)
SWCLK: J2.6, J2.9, U6.76 (PA14)
SWDIO: J2.4, U6.72 (PA13)
TEMP_1: C85.2, J4.13, R62.1, U17.3 (1IN+)
TEMP_1_OUT: U6.22 (PA0), U17.1 (1OUT), U17.2 (1IN-)
TEMP_2: C8.2, J9.13, R61.1, U17.5 (2IN+)
TEMP_2_OUT: U6.17 (PC2_C), U17.6 (2IN-), U17.7 (2OUT)
UD+: R1.2, U2.7 (UD+)
UD-: R2.1, U2.6 (UD-)
USBGND: C2.2, C4.2, C92.2, J1.5 (GND), J1.6 (Shield), JP1.1, U2.2 (GND1), U2.8 (GND1), U18.2 (GND)
VBUS1: C4.1, C92.1, J1.1 (VBUS), U2.1 (VBUS1), U18.5 (VBUS)
VCAP1: C31.1, U6.48 (VCAP1)
VCAP2: C32.1, U6.73 (VCAP2)
VDD1: C2.1, JP1.3, U2.3 (VDD1), U2.4 (PDEN)
VDDA: C22.1, R13.1, U6.21 (VDDA)
VREF: C25.2, R15.2, U6.20 (VREF+)
VSSA: C22.2, C25.1, R14.2, U6.19 (VSSA)
Vin: C39.1, C41.1, C47.1, C48.1, C49.1, C50.1, C51.1, C52.1, C56.1, C57.1, C58.1, C59.1, C60.1, C61.1, C65.1, C66.1, C67.1, C68.1, C69.1, C70.1, D1.1 (A), D1.2 (A), J10.1, Q1.3 (D), Q3.3 (D), Q5.3 (D), Q7.3 (D), Q9.3 (D), Q11.3 (D), R16.1, R28.2, R30.2, R36.2, R37.2, R43.2, R44.2, TP23.1, U7.3 (VDRAIN), U8.3 (VDRAIN)
~Fault1: U6.55 (PD8), U7.17 (nFAULT)
~Fault2: U6.83 (PD2), U8.17 (nFAULT)

Notes on the sheet:
CAN
MCU
SWITCHING CONVERTERS
INVERTER 1
Images/Logos
USB/ISOLATION
DC/DC 13V->3.3V
ENCODER LVDS
DFSDM
Power Breakout
Boot Mode
DC/DC 13V->5V
LED Indicator
MCU CONNECTOR
POWER CONNECTORS
Analog Power Filter
DC/DC 72V->13V
Analog Reference
MOUNTING
INVERTER 2
JTAG
MCU Decouple Caps
MEMS OSCILLATOR
Reset Button
