MidwestMotorBoy/Double-DRV-Motor-Controller/HARDWARE/DRV8350S_Double/DRV8350S_Double.kicad_pcb

## KiCad design HARDWARE/DRV8350S_Double/DRV8350S_Double.kicad_pcb (continued)

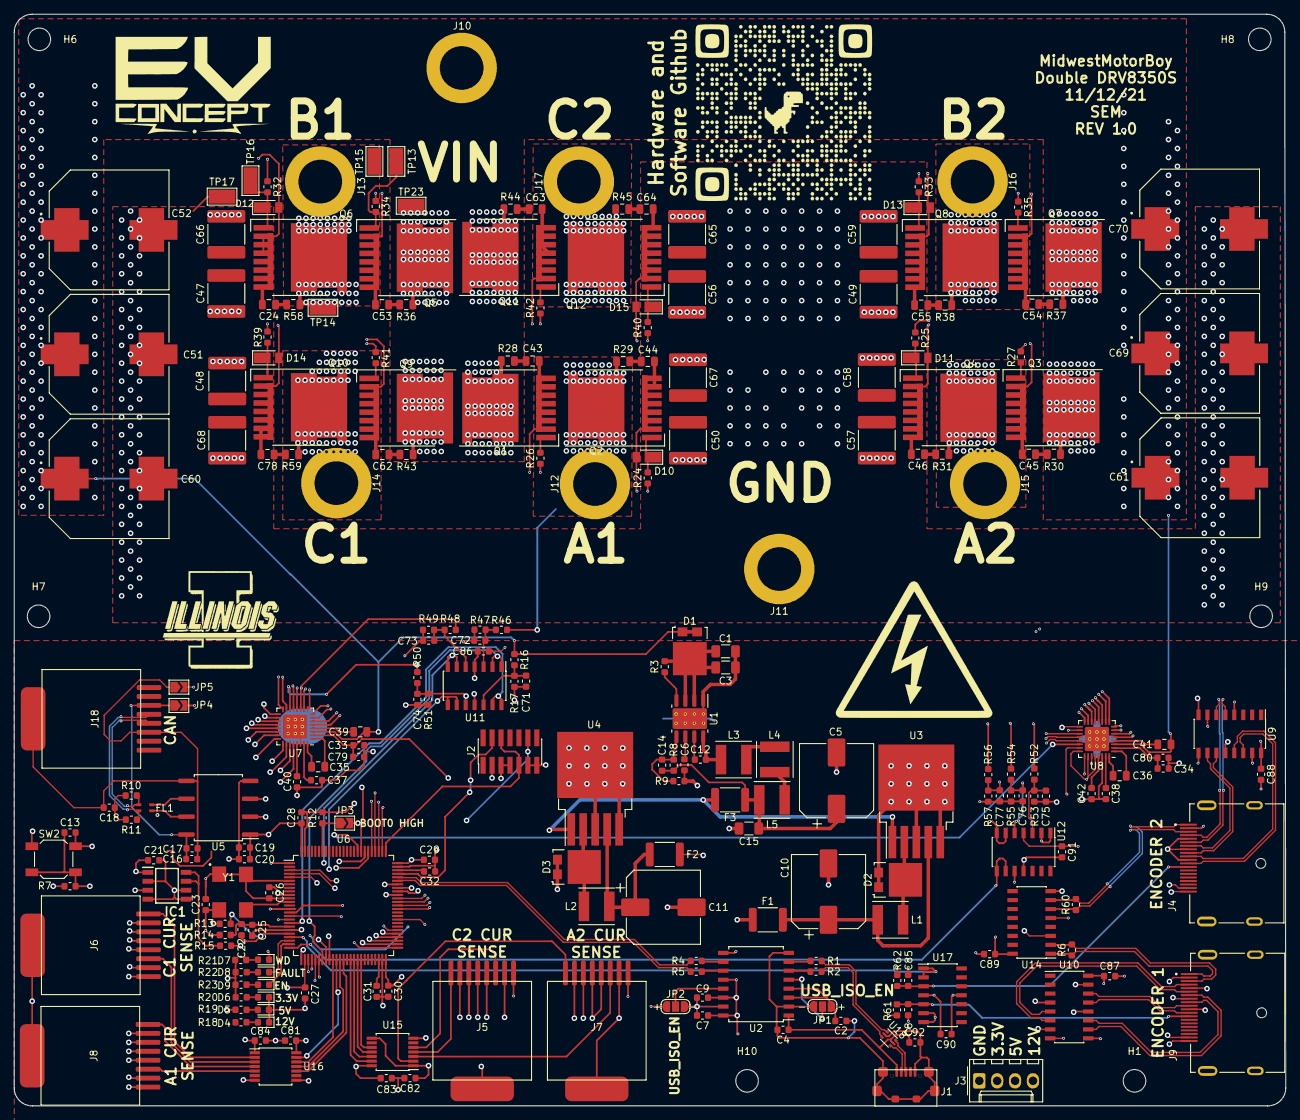
[picture p19: board DRV8350S_Double.kicad_pcb from above]

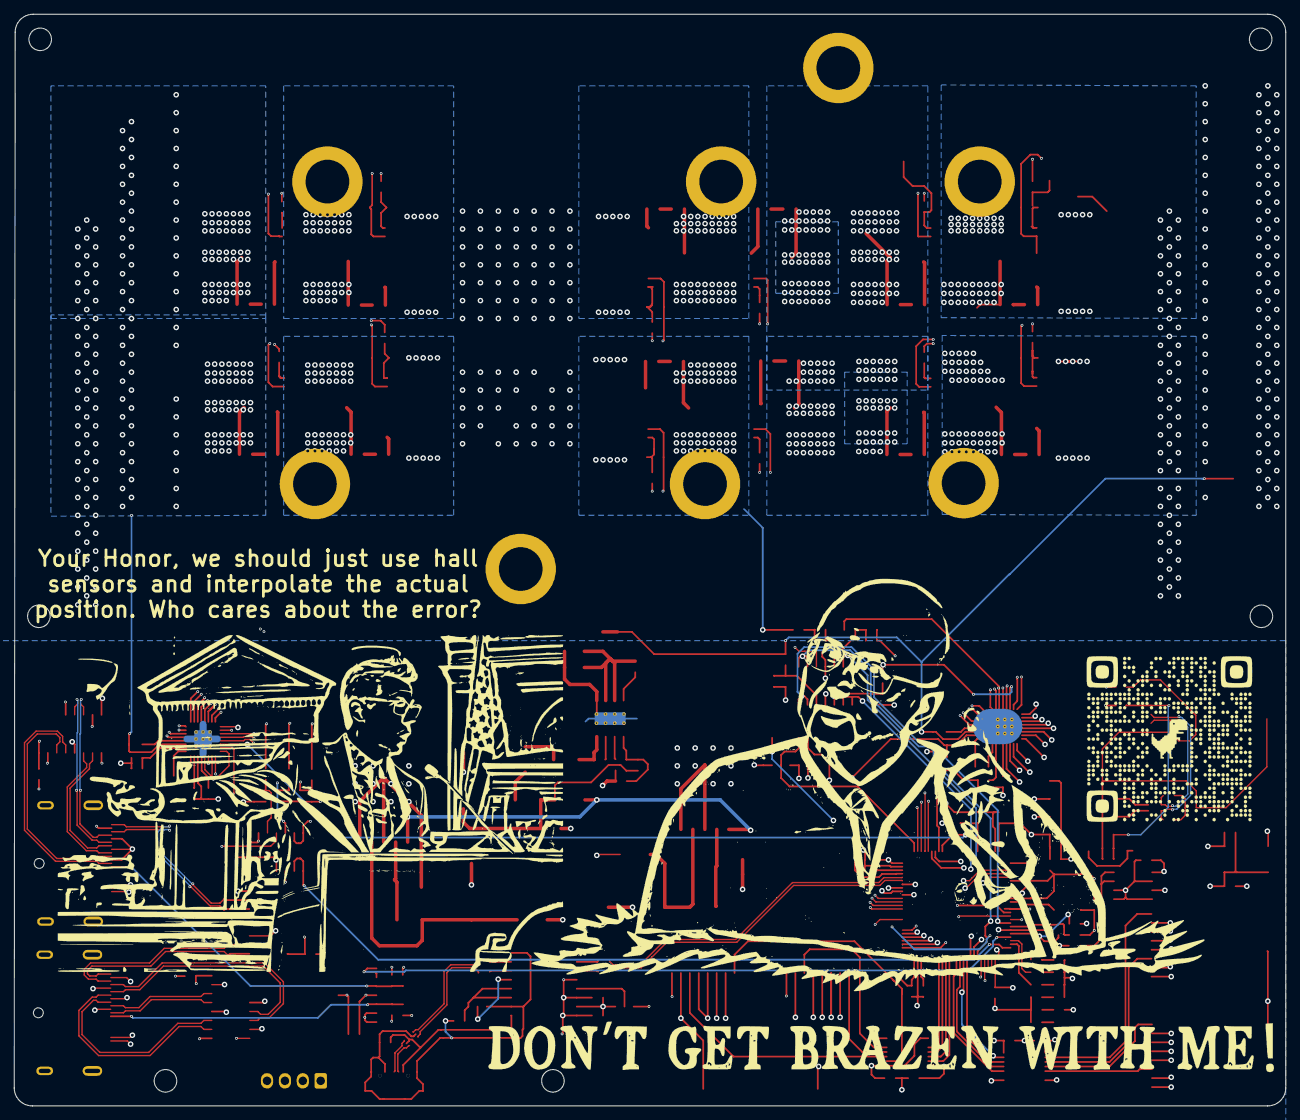
[picture p20: board DRV8350S_Double.kicad_pcb from below]

Board: 4 copper layers, 180.5 x 154.9 mm, 252 parts (3 on the bottom side), 192 nets.
