MidwestMotorBoy/Double-DRV-Motor-Controller/HARDWARE/MA732_encoder/MA732_encoder/MA710_encoder.kicad_pcb

## KiCad design HARDWARE/MA732_encoder/MA732_encoder/MA710_encoder.kicad_pcb (2022-02-12)

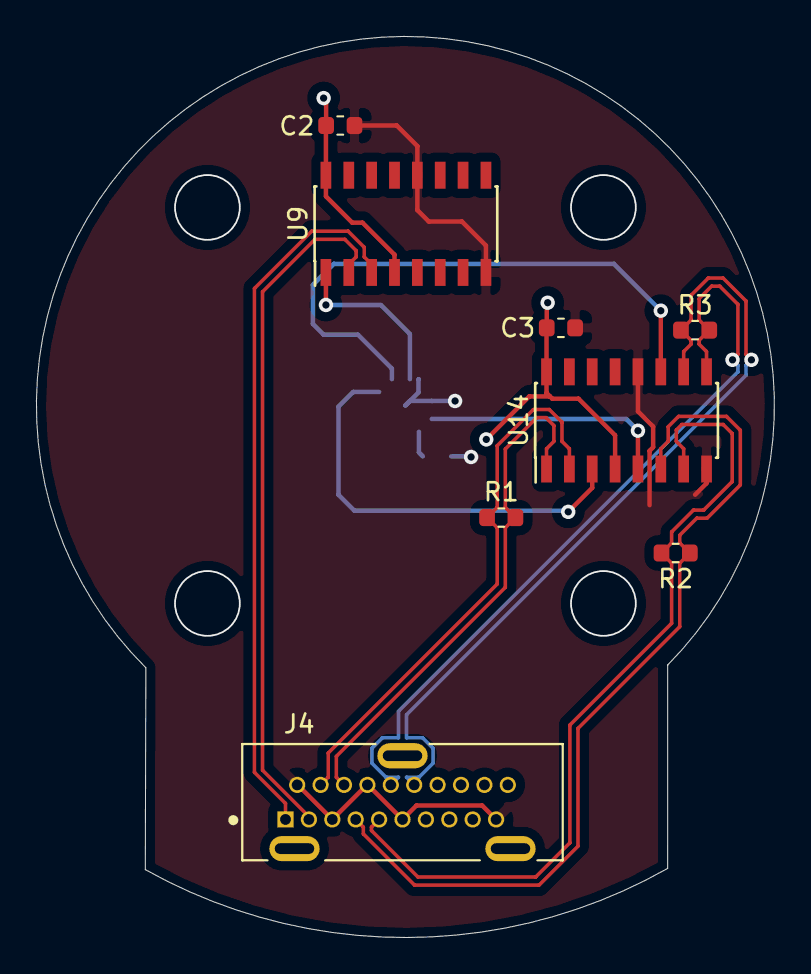
[picture p21: board HARDWARE/MA732_encoder/MA732_encoder/MA710_encoder.kicad_pcb from above]

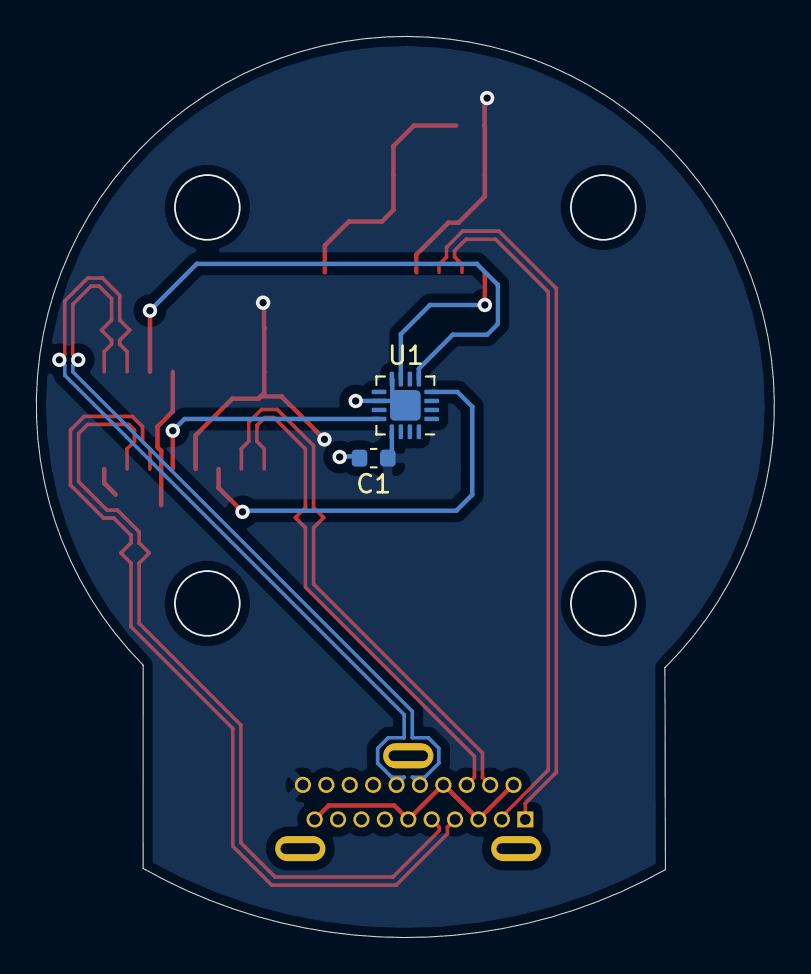
[picture p22: board HARDWARE/MA732_encoder/MA732_encoder/MA710_encoder.kicad_pcb from below]

Board: 2 copper layers, 41.0 x 50.1 mm, 10 parts (2 on the bottom side), 14 nets.

Parts:
C1, C2, C3: 1uF; C_0603_1608Metric
J4: 47272-0001; TE_2041441-1
R1, R2, R3: 100Ω; R_0603_1608Metric
U1: MA730; QFN-16-1EP_3x3mm_P0.5mm_EP1.7x1.7mm
U9: SN65LVDS31D; SOIC-16_3.9x9.9mm_P1.27mm
U14: SN65LVDS33D; SOIC-16_3.9x9.9mm_P1.27mm

Connections:
+3V3: C1.1, C2.1, C3.1, J4.20, U1.13, U9.4, U9.16, U14.4, U14.16
GND: C1.2, C2.2, C3.2, J4.2, J4.5, J4.8, J4.11, J4.19, U1.8, U1.10, U1.17, U9.8, U9.12, U14.8, U14.12
SPI6_MISO: U1.7, U9.1
SPI6_MISO_+: J4.1, U9.3
SPI6_MISO_-: J4.3, U9.2
SPI6_MOSI: U1.4, U14.3
SPI6_MOSI_+: J4.4, R1.1, U14.2
SPI6_MOSI_-: J4.6, R1.2, U14.1
SPI6_SCK: U1.12, U14.5
SPI6_SCK_+: J4.7, R2.1, U14.6
SPI6_SCK_-: J4.9, R2.2, U14.7
SPI6_nSS: U1.5, U14.11
SPI6_nSS_+: J4.10, R3.1, U14.9
SPI6_nSS_-: J4.12, R3.2, U14.10
