MidwestMotorBoy/Double-DRV-Motor-Controller/CANA_BOARD/CANA_BOARD.kicad_pcb

## KiCad design CANA_BOARD/CANA_BOARD.kicad_pcb (2022-02-12)

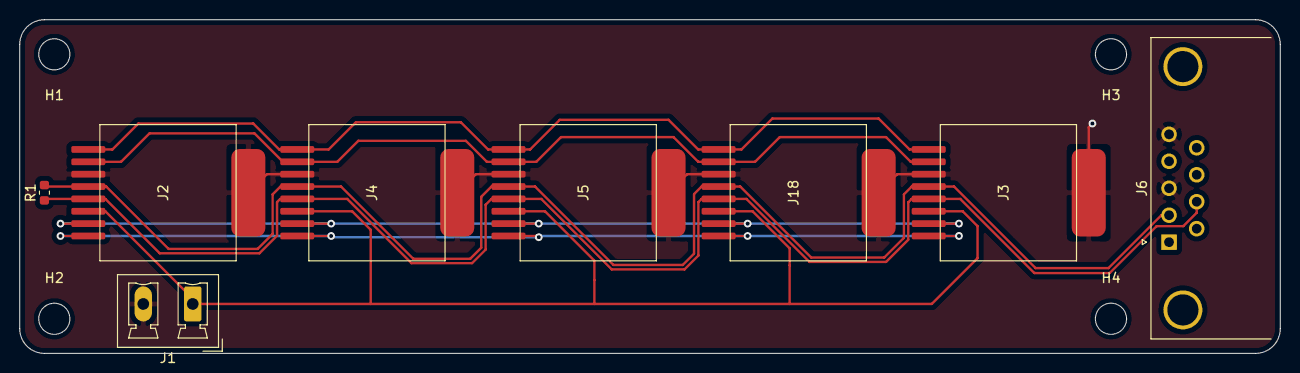
[picture p23: board CANA_BOARD.kicad_pcb from above]

Board: 2 copper layers, 129.5 x 34.3 mm, 12 parts (0 on the bottom side), 8 nets.

Parts:
H1, H2, H3, H4: MountingHole; MountingHole_3.2mm_M3
J1: Conn_01x02_Male; PhoenixContact_MCV_1,5_2-G-5.08_1x02_P5.08mm_Vertical
J2, J3, J4, J5, J18: Conn_01x08; RCH-RC02015
J6: Conn_01x08; DSUB-9_Male_Horizontal_P2.77x2.84mm_EdgePinOffset7.70mm_Hou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
R1: 100Ω; R_0603_1608Metric

Connections:
5V_ISO: J1.1, J2.3, J3.3, J4.3, J5.3, J18.3
CAN_IN+: J2.4, J3.4, J4.4, J5.4, J6.7, J18.4, R1.1
CAN_IN-: J2.5, J3.5, J4.5, J5.5, J6.2, J18.5, R1.2
GND_ISO: J1.2, J2.6, J2.9, J3.6, J3.9, J4.6, J4.9, J5.6, J5.9, J6.3, J6.5, J18.6, J18.9
unnamed: J2.1, J3.1, J4.1, J5.1, J18.1
unnamed: J2.2, J3.2, J4.2, J5.2, J18.2
unnamed: J2.7, J3.7, J4.7, J5.7, J18.7
unnamed: J2.8, J3.8, J4.8, J5.8, J18.8
