MidwestMotorBoy/Double-DRV-Motor-Controller/Core/Src/main.c

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
/* Includes ------------------------------------------------------------------*/
#include "main.h"
#include "usb_device.h"
/* USER CODE BEGIN Includes */
#include "drv8350s.h"
#include "FOC.h"
#include "PI_loop.h"
#include "pos_offset_cal.h"
#include "controller_cfg.h"
/* USER CODE END Includes */

 ADC_HandleTypeDef hadc1;
ADC_HandleTypeDef hadc2;
ADC_HandleTypeDef hadc3;
DMA_HandleTypeDef hdma_adc2;

CORDIC_HandleTypeDef hcordic;

DFSDM_Filter_HandleTypeDef hdfsdm1_filter0;
DFSDM_Filter_HandleTypeDef hdfsdm1_filter1;
DFSDM_Filter_HandleTypeDef hdfsdm1_filter2;
DFSDM_Filter_HandleTypeDef hdfsdm1_filter3;
DFSDM_Channel_HandleTypeDef hdfsdm1_channel1;
DFSDM_Channel_HandleTypeDef hdfsdm1_channel2;
DFSDM_Channel_HandleTypeDef hdfsdm1_channel4;
DFSDM_Channel_HandleTypeDef hdfsdm1_channel5;

FDCAN_HandleTypeDef hfdcan1;

FMAC_HandleTypeDef hfmac;

SPI_HandleTypeDef hspi2;
SPI_HandleTypeDef hspi3;
SPI_HandleTypeDef hspi4;
SPI_HandleTypeDef hspi6;

TIM_HandleTypeDef htim1;
TIM_HandleTypeDef htim2;
TIM_HandleTypeDef htim4;
TIM_HandleTypeDef htim8;

/* USER CODE BEGIN PV */
	//uint32_t __attribute__((section("RAM_D1"))) adc1[4]={0} ;
uint32_t adc1[4]={0} ;
uint32_t adc2[3]={0};
uint32_t adc3[2]={0};
int request_pos = 0xffff;
float data2angle = 360.0 / 4096;
int volatile position=0;
int volatile position_2=0;
float angle=0,angle_2=0;
float foc_angle=0,speed=0;
int adc_count=0;
/* USER CODE END PV */

void SystemClock_Config(void);
void PeriphCommonClock_Config(void);
static void MX_GPIO_Init(void);
static void MX_ADC1_Init(void);
static void MX_ADC2_Init(void);
static void MX_CORDIC_Init(void);
static void MX_DFSDM1_Init(void);
static void MX_FDCAN1_Init(void);
static void MX_FMAC_Init(void);
static void MX_SPI2_Init(void);
static void MX_SPI3_Init(void);
static void MX_SPI4_Init(void);
static void MX_SPI6_Init(void);
static void MX_TIM1_Init(void);
static void MX_TIM8_Init(void);
static void MX_DMA_Init(void);
static void MX_TIM2_Init(void);
static void MX_ADC3_Init(void);
static void MX_TIM4_Init(void);
/* USER CODE BEGIN 0 */
//	uint32_t adc1[4];

/* USER CODE END 0 */

/**
  * @brief  The application entry point.
  * @retval int
  */
int main(void)
{
  /* Enable I-Cache---------------------------------------------------------*/
  SCB_EnableICache();

  /* MCU Configuration--------------------------------------------------------*/

  /* Reset of all peripherals, Initializes the Flash interface and the Systick. */
  HAL_Init();

  /* Configure the system clock */
  SystemClock_Config();

/* Configure the peripherals common clocks */
  PeriphCommonClock_Config();

  /* USER CODE BEGIN SysInit */
//  volatile uint32_t adc1;

  /* USER CODE END SysInit */

  /* Initialize all configured peripherals */
  MX_GPIO_Init();
  MX_ADC1_Init();
  MX_ADC2_Init();
  MX_CORDIC_Init();
  MX_DFSDM1_Init();
  MX_FDCAN1_Init();
  MX_FMAC_Init();
  MX_SPI2_Init();
  MX_SPI3_Init();
  MX_SPI4_Init();
  MX_SPI6_Init();
  MX_TIM1_Init();
  MX_TIM8_Init();
  MX_DMA_Init();
  MX_USB_DEVICE_Init();
  MX_TIM2_Init();
  MX_ADC3_Init();
  MX_TIM4_Init();
  /* USER CODE BEGIN 2 */
  HAL_GPIO_WritePin(FAULT_LED_GPIO_Port, FAULT_LED_Pin, GPIO_PIN_SET);
  HAL_GPIO_WritePin(BRD_EN_GPIO_Port, BRD_EN_Pin, GPIO_PIN_SET);
  HAL_Delay (100);
  if(HAL_DFSDM_FilterRegularStart(&hdfsdm1_filter0) != HAL_OK){
	  Error_Handler();
  }
  if(HAL_DFSDM_FilterRegularStart(&hdfsdm1_filter1) != HAL_OK){
	  Error_Handler();
  }
  if(HAL_DFSDM_FilterRegularStart(&hdfsdm1_filter2) != HAL_OK){
	  Error_Handler();
  }
  if(HAL_DFSDM_FilterRegularStart(&hdfsdm1_filter3) != HAL_OK){
	  Error_Handler();
  }
  HAL_TIM_Base_Start_IT(&htim1);
  HAL_TIM_PWM_Start(&htim1, TIM_CHANNEL_1);
  HAL_TIM_PWM_Start(&htim1, TIM_CHANNEL_2);
  HAL_TIM_PWM_Start(&htim1, TIM_CHANNEL_3);
  HAL_TIM_PWM_Start(&htim1, TIM_CHANNEL_4);
  HAL_TIM_Base_Start_IT(&htim2);
  HAL_TIM_Base_Start(&htim4);
//  HAL_TIM_Base_Start_IT(&htim8);
  TIM4->CCER = 0b0000010101010101;
  TIM4->CCR1 = 10000;
  TIM1->CCER = 0b0000010101010101;
  TIM1->CCR1 = 0;
  TIM1->CCR2 = 0;
  TIM1->CCR3 = 0;
  TIM1->CCR4 = 0;
  uint8_t data[] = "Hello World from USB CDC123\n";
  float current_C1 = 0, current_A1 = 0, current_C2 = 0, current_A2 = 0;
  float prev_angle,angle_sum;
  uint8_t result=0;
  uint32_t channel1 = 0, channel2 = 0, channel4 = 0, channel5 = 0;
  uint16_t length = strlen(data);
  uint16_t regs_data[6] = {0};
  /*
  if(HAL_ADC_Start_DMA(&hadc1, adc1, 4) != HAL_OK){
  	  Error_Handler();
  }
  */
  //HAL_ADC_Start_DMA(&hadc2, adc2, 3);
 //HAL_ADC_Start_DMA(&hadc3, adc3, 1);
  HAL_ADC_Start(&hadc3);
  // Setup DRV
  HAL_GPIO_WritePin(DRV1_EN_GPIO_Port, DRV1_EN_Pin, GPIO_PIN_SET);
  HAL_GPIO_WritePin(DRV2_EN_GPIO_Port, DRV2_EN_Pin, GPIO_PIN_SET);
  HAL_GPIO_WritePin(GPIOA, FAULT_LED_Pin|BRD_EN_Pin, GPIO_PIN_SET);
  HAL_GPIO_WritePin(INV1_EN_GPIO_Port, INV1_EN_Pin, GPIO_PIN_SET);
  HAL_SPI_TransmitReceive(&hspi6, (uint8_t*) &request_pos, (uint8_t*) &position, 1, 100);

  //spi setup
  set_driver_ctrl_reg(&hspi2, SHUTDOWN_ALL_BRIDGES, UVLO_EN, GATE_DRV_FAULT_EN, OTW_REPORT_EN, PWM_3X, SYNC_RECT, CW, COAST_DIS, NO_TPS);
  set_hs_driver_reg(&hspi2, UNLOCK_REGS, IDRIVEP_1000MA, IDRIVEN_1200MA);
  set_ls_driver_ctrl_reg(&hspi2, RETRY_ONLY, PK_CUR_2000NS, IDRIVEP_1000MA, IDRIVEN_1200MA);
  set_ocp_ctrl_reg(&hspi2, RETRY_8MS, DEAD_TIME_200NS, OC_LATCHED, OCP_DEG_8US, VDS_LVL_1_0V);
  HAL_Delay(10);
  clear_flt(&hspi2);
  HAL_Delay(10);
  float ma732_offset_pre = read_offset(&hspi4);
  MA732_ROT_DIR ma732_dir_pre = read_rot_dir(&hspi4);
  reset_offset_and_dir(&hspi4);
  float ma732_offset_post_reset = read_offset(&hspi4);
  MA732_ROT_DIR ma732_dir_post_reset = read_rot_dir(&hspi4);
  SENSOR_OFFSET_E mot_offset_1 = get_pos_offset(TIM1, &hspi4);
  //SENSOR_OFFSET_E mot_offset_2 = get_pos_offset(TIM8, &hspi6);
  //set_offset(&hspi4, mot_offset_1.offset);
  set_dir(&hspi4,mot_offset_1.direction);
  HAL_Delay(10);
  SENSOR_OFFSET_E mot_offset_1_rnd2 = get_pos_offset(TIM1, &hspi4);
  set_offset(&hspi4, mot_offset_1_rnd2.offset);
  float ma732_offset_after = read_offset(&hspi4);
  MA732_ROT_DIR ma732_dir_after = read_rot_dir(&hspi4);
  int32_t tim_period = TIM1->ARR;
  int Va, Vb, Vc, min_val;
  /* USER CODE END 2 */

  /* Infinite loop */
  /* USER CODE BEGIN WHILE */
  while (1)
  {
	  read_all_regs(&hspi2, regs_data);
	  current_C1 = HAL_DFSDM_FilterGetRegularValue(&hdfsdm1_filter0, &channel1) * CURRENT_A_SCALER;
	  current_A1 = HAL_DFSDM_FilterGetRegularValue(&hdfsdm1_filter1, &channel2) * CURRENT_A_SCALER;
	  current_C2 = HAL_DFSDM_FilterGetRegularValue(&hdfsdm1_filter2, &channel4) * CURRENT_A_SCALER;
	  current_A2 = HAL_DFSDM_FilterGetRegularValue(&hdfsdm1_filter3, &channel5) * CURRENT_A_SCALER;
	  int dc_bus_fxpt = HAL_ADC_GetValue(&hadc3);
	  float dc_bus = dc_bus_fxpt*0.028998778998779f;
	  HAL_SPI_TransmitReceive(&hspi6, (uint8_t*) &request_pos, (uint8_t*) &position_2, 1, 100);
	  HAL_SPI_TransmitReceive(&hspi4, (uint8_t*) &request_pos, (uint8_t*) &position, 1, 100);
	  int position_temp = position >> 4;
	  int position_temp_2 = position_2 >> 4;
	  angle = data2angle * position_temp;
	  angle_2 = data2angle * position_temp_2;
	  //speed cal
	  float diff_angle = angle - prev_angle;
	  if(diff_angle > 180){
		  diff_angle -= 360;
	  }
	  else if(diff_angle < -180){
		diff_angle += 360;
	  }
	  angle_sum += diff_angle;
	  prev_angle = angle;
	  uint16_t e_position= ((position_temp * mot_offset_1.pole_pairs))%1024;
	  inv_parkclark(&Va, &Vb, &Vc, e_position, 400, 0);
	  min_val = find_min_voltage(Va, Vb, Vc);
	  Va -= min_val;
	  Vb -= min_val;
	  Vc -= min_val;
	  TIM1->CCR1 = (Va*tim_period)/DC_BUS_V;
	  TIM1->CCR2 = (Vb*tim_period)/DC_BUS_V;
	  TIM1->CCR3 = (Vc*tim_period)/DC_BUS_V;

	  //	  uint32_t *adc1_add = adc1;
	  HAL_Delay (1);
    /* USER CODE END WHILE */

    /* USER CODE BEGIN 3 */
  }
  /* USER CODE END 3 */
}

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
