MidwestMotorBoy/Double-DRV-Motor-Controller/DRV8350s_Dual.ioc

Mcu.UserName=STM32H730VBTx
PA0.Signal=ADC1_INP16
PA1.GPIO_Label=FAULT_LED
PA1.Signal=GPIO_Output
PA10.Signal=S_TIM1_CH3
PA11.Signal=USB_OTG_HS_DM
PA12.Signal=USB_OTG_HS_DP
PA13(JTMS/SWDIO).Signal=DEBUG_JTMS-SWDIO
PA14(JTCK/SWCLK).Signal=DEBUG_JTCK-SWCLK
PA15(JTDI).Signal=SPI3_NSS
PA2.GPIO_Label=BRD_EN
PA2.Signal=GPIO_Output
PA3.Signal=ADCx_INP15
PA4.Signal=SPI6_NSS
PA5.Signal=SPI6_SCK
PA6.Signal=SPI6_MISO
PA7.Signal=SPI6_MOSI
PA8.Signal=S_TIM1_CH1
PA9.Signal=S_TIM1_CH2
PB0.Signal=ADCx_INP9
PB1.Signal=S_DATAIN1DFSDM1
PB12.Signal=SPI2_NSS
PB13.Signal=SPI2_SCK
PB14.Signal=SPI2_MISO
PB15.Signal=SPI2_MOSI
PB2.Signal=S_CKIN1DFSDM1
PC0.Signal=ADCx_INP10
PC1.Signal=ADCx_INP11
PC10.Signal=SPI3_SCK
PC11.Signal=SPI3_MISO
PC12.Signal=SPI3_MOSI
PC2_C.Signal=ADC3_INP0
PC3_C.Signal=ADC3_INP1
PC4.Signal=ADCx_INP4
PC5.Signal=ADCx_INP8
PC6.Signal=S_TIM8_CH1
PC7.Signal=S_TIM8_CH2
PC8.Signal=S_TIM8_CH3
PC9.GPIO_Label=INV1_EN
PC9.Signal=GPIO_Output
PD0.Signal=FDCAN1_RX
PD1.Signal=FDCAN1_TX
PD12.Signal=S_TIM4_CH1
PD15.GPIO_Label=INV2_EN
PD15.Signal=GPIO_Output
PD2.GPIO_Label=nFault2
PD2.Signal=GPIO_Input
PD3.GPIO_Label=DRV2_EN
PD3.Signal=GPIO_Output
PD8.GPIO_Label=FAULT1
PD8.Signal=GPIO_Input
PD9.GPIO_Label=DRV1_EN
PD9.Signal=GPIO_Output
PE10.Signal=S_DATAIN4DFSDM1
PE11.Signal=S_CKIN4DFSDM1
PE12.Signal=S_DATAIN5DFSDM1
PE13.Signal=S_CKIN5DFSDM1
PE2.Signal=SPI4_SCK
PE4.Signal=SPI4_NSS
PE5.Signal=SPI4_MISO
PE6.Signal=SPI4_MOSI
PE7.Signal=S_DATAIN2DFSDM1
PE8.Signal=S_CKIN2DFSDM1
PH0-OSC_IN.Signal=RCC_OSC_IN
