MidwestMotorBoy/Double-DRV-Motor-Controller/Core/Inc/main.h

#define FAULT_LED_Pin GPIO_PIN_1
#define FAULT_LED_GPIO_Port GPIOA
#define BRD_EN_Pin GPIO_PIN_2
#define BRD_EN_GPIO_Port GPIOA
#define FAULT1_Pin GPIO_PIN_8
#define FAULT1_GPIO_Port GPIOD
#define DRV1_EN_Pin GPIO_PIN_9
#define DRV1_EN_GPIO_Port GPIOD
#define INV2_EN_Pin GPIO_PIN_15
#define INV2_EN_GPIO_Port GPIOD
#define INV1_EN_Pin GPIO_PIN_9
#define INV1_EN_GPIO_Port GPIOC
#define nFault2_Pin GPIO_PIN_2
#define nFault2_GPIO_Port GPIOD
#define DRV2_EN_Pin GPIO_PIN_3
#define DRV2_EN_GPIO_Port GPIOD
#define CURRENT_A_SCALER 0.01373291015f
