MidwestMotorBoy/Double-DRV-Motor-Controller/Core/Inc/controller_cfg.h

/*
 * controller_cfg.h
 *
 *  Created on: Jun 15, 2022
 *      Author: MidwestMotorBoy
 */

#ifndef INC_CONTROLLER_CFG_H_
#define INC_CONTROLLER_CFG_H_

#define DC_BUS_V 30000 //mV
#define POS_OFFSET_TEST_V 1000 //mV


#endif /* INC_CONTROLLER_CFG_H_ */
