MidwestMotorBoy/Double-DRV-Motor-Controller/(commit log)

2021-11-29 Init commit
    [DRV8350S_Double-B_Cu.gbr, DRV8350S_Double-B_Mask.gbr, DRV8350S_Double-B_Paste.gbr, DRV8350S_Double-B_SilkS.gbr, DRV8350S_Double-Edge_Cuts.gbr, DRV8350S_Double-F_Cu.gbr, DRV8350S_Double-F_Mask.gbr, DRV8350S_Double-F_Paste.gbr]
2021-11-29 fixed iso_gnd miss
    [DRV8350S_Double.kicad_pcb, DRV8350S_Double.sch]
2022-02-12 Backing up current design
    Fucked up something with STM32 and displayport is dumb
    [CANA_BOARD-B_Cu.gbr, CANA_BOARD-B_Mask.gbr, CANA_BOARD-B_Paste.gbr, CANA_BOARD-B_SilkS.gbr, CANA_BOARD-Edge_Cuts.gbr, CANA_BOARD-F_Cu.gbr, CANA_BOARD-F_Mask.gbr, CANA_BOARD-F_Paste.gbr]
2022-06-18 Commiting a ton of work, working current, position sensors, motion pos calibration routine done
    [MA710_encoder-B_Cu.gbr, MA710_encoder-B_Mask.gbr, MA710_encoder-B_Paste.gbr, MA710_encoder-B_Silkscreen.gbr, MA710_encoder-Edge_Cuts.gbr, MA710_encoder-F_Cu.gbr, MA710_encoder-F_Mask.gbr, MA710_encoder-F_Paste.gbr]
2022-06-18 Moved hardware files into the hardware folder
    [Current_Sense-B_Cu.gbr, Current_Sense-B_Mask.gbr, Current_Sense-B_Paste.gbr, Current_Sense-B_SilkS.gbr, Current_Sense-B_Silkscreen.gbr, Current_Sense-Edge_Cuts.gbr, Current_Sense-F_Cu.gbr, Current_Sense-F_Mask.gbr]
2022-06-25 Silk Screen Changes
    [Current_Sense.kicad_pcb, DRV8350S_Double.kicad_pcb, DRV8350S_Double.kicad_sch, MA710_encoder.kicad_pcb]
